jiang-zexuan/k230-42-stepper-vision-tracking-2d-gimbal/firmware/stm32f407/README.md

# STM32F407 固件

本目录预留给 STM32CubeIDE/CubeMX 工程、应用代码和板级代码。

当前状态：尚未创建 ioc 文件。板卡具体型号、时钟、串口实例、引脚复用和调试接口必须在查阅正点原子开发板资料并完成板级自检后写入工程。

规划分层：

- BSP：GPIO、UART、DMA、定时器和步进脉冲。
- Drivers：X42S STEP/DIR/EN、K230 协议、日志接口。
- Services：运动规划、位置估算、目标跟踪、故障管理。
- App：FreeRTOS 任务与系统状态机。
- Tests：可在主机或硬件环境复现的测试。
