jiang-zexuan/k230-42-stepper-vision-tracking-2d-gimbal/scripts/protocol-tools/README.md

# 协议工具

后续存放 UART 帧生成、CRC 校验和解析回放工具。工具输入输出格式及测试向量必须与 docs/03-interfaces/k230-f407-uart.md 一致。
