jiang-zexuan/k230-42-stepper-vision-tracking-2d-gimbal/hardware/datasheets/yahboom-k230-standard/README.md

# Yahboom K230 标准版资料索引

本目录包含用户提供的 15 张原始说明图，直接纳入 Git。图片是供应商资料副本，不替代最新官网文档或模块丝印核对。

## 已确认的可查找信息

| 原图 | 主题 | 可引用的关键事实 | 状态 |
| --- | --- | --- | --- |
| K230视觉模块-标准版_1.jpg | 封面 | 标准版资料集合的来源。 | 资料证据 |
| K230视觉模块-标准版_2.jpg | 包装与清单 | 可用于核验随附配件。 | 待逐项核对 |
| K230视觉模块-标准版_3.jpg | 接口概览 | 展示板载接口与 12 Pin 扩展口。 | 资料证据 |
| K230视觉模块-标准版_4.jpg | 12 Pin GPIO | 标注 IO33 为 UART3_RXD、IO32 为 UART3_TXD；存在 GND 与 5 V 引脚。 | 待实物核对 |
| K230视觉模块-标准版_5.jpg 至 _8.jpg | 散热支架装配 | 用于机械安装参考。 | 待采用时核对 |
| K230视觉模块-标准版_9.jpg | TF 卡安装 | 用于存储卡操作参考。 | 资料证据 |
| K230视觉模块-标准版_10.jpg 至 _14.jpg | CanMV IDE 与示例 | 用于现成视觉示例运行参考。 | 待复现实测 |
| K230视觉模块-标准版_15.jpg | 功能布局与常见问题 | 用于模块能力和使用注意事项索引。 | 待逐项核对 |

## 当前引用规则

- UART3 接线设计基线仅引用 _4.jpg 中的命名：IO32/TXD、IO33/RXD。连接前必须复核模块丝印和最新厂商资料。
- 资料中出现的典型电流、供电和能力描述都不是本项目的实测结果；项目电气参数以未来实验记录为准。
- 需要引用某一页时，写出完整文件名、资料版本（如可识别）和该页可见内容，避免只凭记忆转述。
