jiang-zexuan/k230-42-stepper-vision-tracking-2d-gimbal/docs/03-interfaces/pin-map.md

# PanView 接线与引脚基线

- 记录日期：2026-09-02
- 适用工程：`E:\Fluushbonading\FreeRTOS\Project\PanView`
- 参考工程：`firmware/stm32f407/PanViewF407`
- 当前状态：设计基线；新工程首次生成后需在 CubeMX、开发板丝印和实机上复核
- 接线变更：用户确认与旧工程相同，当前按原接线使用

## 证据和状态说明

本表的 F407 引脚来自旧工程 `PanViewF407.ioc`、`Core/Inc/main.h` 和 `Core/Src/main.c`；“接线未变”来自 2026-09-02 的操作者确认。它可以作为新工程 CubeMX 配置基线，但不替代新工程的引脚复核、万用表检查和低风险上电验证。

状态含义：

- **设计基线**：允许用于创建新工程配置，尚未代表新工程实测。
- **用户确认沿用**：接线相对旧工程未变的当前输入。
- **待验证**：需要通过 CubeMX 配置检查、开发板资料或实机测量确认。

## K230 与 F407 视觉串口

| 设备 | 信号 | 引脚/接口 | 连接方向 | 证据 | 状态 |
| --- | --- | --- | --- | --- | --- |
| K230 标准版 | UART3_TXD | IO32 | K230 TX -> F407 USART2_RX | 旧项目 pin-map 与用户沿用确认 | 用户确认沿用；待验证 |
| K230 标准版 | UART3_RXD | IO33 | F407 USART2_TX -> K230 RX | 旧项目 pin-map 与用户沿用确认 | 用户确认沿用；待验证 |
| K230 标准版 | 5V | 专用 UART 接口 5V | 供电 | 用户提供 | 用户确认沿用；待验证 |
| K230 标准版 | GND | 专用 UART 接口 GND | 与 F407、驱动器逻辑地共地 | AGENTS.md 接线约束与用户沿用确认 | 用户确认沿用；待验证 |
| STM32F407 | USART2_TX | PA2 | -> K230 RX | `PanViewF407.ioc` | 设计基线；待验证 |
| STM32F407 | USART2_RX | PA3 | <- K230 TX | `PanViewF407.ioc` | 设计基线；待验证 |
| STM32F407 | USART2_RX DMA | DMA1 Stream 5 | USART2 接收搬运 | `PanViewF407.ioc` | 设计基线；待验证 |

说明：F407 端的 K230 接收业务归属 USART2；新架构中 USART2 DMA/IDLE 的中断只负责搬运数据和通知 `VisionRxTask`。

## USART1 调试日志和文本命令

| 信号 | F407 引脚 | 用途 | DMA/中断 | 状态 |
| --- | --- | --- | --- | --- |
| USART1_TX | PA9 | 调试日志、遥测和命令响应 | USART1 IRQ | 设计基线；待验证 |
| USART1_RX | PA10 | PC/调试端命令接收 | DMA2 Stream 2 + USART1 IRQ | 设计基线；待验证 |
| USART1_RX DMA | DMA2 Stream 2 | 接收搬运 | DMA IRQ 优先级沿用旧工程 | 设计基线；待验证 |

USART1 的发送必须由统一发送服务保护；新架构中不允许多个任务直接并发调用阻塞式 HAL 发送。

## X42S 两轴 STEP/DIR/EN

| 轴 | 信号 | F407 引脚 | 定时器 | 旧工程语义 | 状态 |
| --- | --- | --- | --- | --- | --- |
| 水平轴 | STEP | PB6 | TIM4_CH1 PWM | 由 TIM4 产生脉冲 | 用户确认沿用；待验证 |
| 水平轴 | DIR | PB7 | GPIO 输出 | 方向电平由旧工程方向映射决定 | 用户确认沿用；待验证 |
| 水平轴 | EN | PG15 | GPIO 输出 | 旧工程 `SET` 为接管/使能，`RESET` 为失能；电气有效电平需实测 | 用户确认沿用；待验证 |
| 俯仰轴 | STEP | PC9 | TIM3_CH4 PWM | 由 TIM3 产生脉冲 | 用户确认沿用；待验证 |
| 俯仰轴 | DIR | PC8 | GPIO 输出 | 旧工程已实测方向映射：低电平向上、高电平向下 | 旧工程实测；新工程待复核 |
| 俯仰轴 | EN | PC7 | GPIO 输出 | 旧工程 `SET` 为接管/使能，`RESET` 为失能；电气有效电平需实测 | 用户确认沿用；待验证 |
| 逻辑地 | GND | 驱动器逻辑地 | 与 F407/K230 共地 | AGENTS.md 接线约束 | 用户确认沿用；待验证 |

定时器约束：TIM3/TIM4 继续负责精确 STEP 波形；`StepperTask` 只更新方向、使能、频率和运行状态，不使用 `osDelay()` 生成脉冲。

## TFT（ILI9341 类 SPI）

| 信号 | F407 引脚/接口 | 状态 |
| --- | --- | --- |
| SCK | PB3 / SPI1_SCK | 设计基线；待验证 |
| MISO | PB4 / SPI1_MISO | 设计基线；待验证 |
| MOSI | PB5 / SPI1_MOSI | 设计基线；待验证 |
| CS | PC13 / GPIO，标签 `TFT_LCD_CS` | 设计基线；待验证 |
| DC | PA5 / GPIO，标签 `TFT_LCD_DC` | 设计基线；待验证 |
| RST | PA6 / GPIO，标签 `TFT_LCD_RST` | 设计基线；待验证 |
| BL | PB15 / GPIO，标签 `TFT_LCD_BL` | 设计基线；待验证 |

旧 `.ioc` 中 SPI1 波特率配置为 8.0 Mbit/s；新工程应先沿用配置，再通过显示初始化和纯色刷新实测。

## FT6336G 触摸

| 信号 | F407 引脚/接口 | 状态 |
| --- | --- | --- |
| SCL | PB8 / I2C1_SCL | 设计基线；待验证 |
| SDA | PB9 / I2C1_SDA | 设计基线；待验证 |
| RST | PE5 / GPIO，标签 `CTP_RST` | 设计基线；待验证 |
| INT | PE6 / GPIO 输入，标签 `CTP_INT` | 设计基线；待验证 |

当前旧工程采用触摸轮询；是否在新工程启用 INT 唤醒，作为 InputTask 后续小任务的单独设计决策。

## ES8388 音频

| 信号 | F407 引脚/接口 | 状态 |
| --- | --- | --- |
| I2S_WS | PB12 / I2S2_WS | 设计基线；待验证 |
| I2S_CK | PB13 / I2S2_CK | 设计基线；待验证 |
| I2S_SD | PC3 / I2S2_SD | 设计基线；待验证 |
| I2S_MCK | PC6 / I2S2_MCK | 设计基线；待验证 |
| 配置总线 SCL | PB8 / I2C1_SCL | 与 FT6336G 共用 I2C1，地址和仲裁需复核 | 待验证 |
| 配置总线 SDA | PB9 / I2C1_SDA | 与 FT6336G 共用 I2C1，地址和仲裁需复核 | 待验证 |

旧 `.ioc` 目标音频频率为 48 kHz，实际值记录为 46.875 kHz；新工程先记录为配置基线，不当作新工程实测值。

## 按键、状态灯和命中指示

| 功能 | F407 引脚 | 旧工程输入/输出语义 | 状态 |
| --- | --- | --- | --- |
| KEY0 | PE4 | GPIO 输入，上拉，按下为低电平 | 用户确认沿用；待验证 |
| KEY1 | PE3 | GPIO 输入，上拉，按下为低电平 | 用户确认沿用；待验证 |
| KEY2 | PE2 | GPIO 输入，上拉，按下为低电平 | 用户确认沿用；待验证 |
| KEY_UP | PA0 | GPIO 输入，下拉，按下为高电平 | 用户确认沿用；待验证 |
| 状态 LED | PF9 | GPIO 输出，旧工程初始化为高电平 | 用户确认沿用；待验证 |
| 命中指示 | PF10 | GPIO 输出，旧工程高电平点亮、低电平关闭 | 用户确认沿用；待验证 |

## 调试和复核清单

新工程 T00 首次生成后必须逐项确认：

1. CubeMX 的引脚标签、外设复用和 DMA Stream 与本表一致。
2. PA13/PA14 SWD 调试接口未被占用。
3. 两个定时器 PWM 输出没有被其他外设复用覆盖。
4. I2C1 共用设备地址不冲突，必要时通过总线扫描或读 ID 验证。
5. UART 逻辑电平、5V 供电和共地在接线前依据开发板和模块资料复核。
6. 新工程下载后先验证 LED/UART，再验证 TFT/触摸，最后才接入电机使能和 STEP 输出。
