jiang-zexuan/k230-42-stepper-vision-tracking-2d-gimbal/docs/00-project/中文导航.md

# PanView 中文学习导航

本项目以中文学习说明为主，保留代码中的英文术语、HAL API 和变量名。这样既能看懂工程意图，也能与 STM32 官方资料和真实代码一一对应；不维护两套内容相同的中英文文档。

## 从哪里开始看

1. 先读[项目化学习规划书](project-based-learning-plan.md)，了解 P01 到 P12 的目标与验收条件。
2. 再读[学习地图](learning-map.md)，把每个小项目放回最终双轴跟踪云台的数据流中理解。
3. 进入当前固件工程：[PanViewF407](../../firmware/stm32f407/PanViewF407)。手写学习代码位于 `Core/Inc`、`Core/Src` 和 `Tests`；CubeMX/ST 自动生成代码保持原样。

## 已完成学习记录

| 阶段 | 核心能力 | 复盘 | 实测与测试 |
| --- | --- | --- | --- |
| P01 板级诊断台 | CubeIDE、SWD、LED、KEY0、USART1 串口日志 | [P01 复盘](../05-learning-log/p01-f407-board-diagnostics-review.md) | [实验 EXP-0002](../06-experiments/EXP-0002-f407-board-bringup.md)，[测试 TEST-0001](../07-test/TEST-0001-f407-board-bringup.md) |
| P02 非阻塞定时任务台 | SysTick、软件周期任务、按键消抖状态机 | [P02 复盘](../05-learning-log/p02-nonblocking-timed-tasks-review.md) | [实验 EXP-0003](../06-experiments/EXP-0003-p02-nonblocking-timed-tasks.md)，[测试 TEST-0002](../07-test/TEST-0002-p02-nonblocking-timed-tasks.md) |
| P03 UART DMA 协议实验器 | DMA、IDLE、流式组帧、CRC、超时、序号统计 | [P03 复盘](../05-learning-log/p03-uart-dma-protocol-review.md) | [实验 EXP-0004](../06-experiments/EXP-0004-p03-uart-dma-protocol.md)，[测试 TEST-0003](../07-test/TEST-0003-p03-uart-dma-protocol.md) |
| P04 K230 视觉结果发布器 | 人脸检测、检测框、坐标、FPS、UART 文本输出 | [P04 复盘](../05-learning-log/p04-k230-vision-result-publisher-review.md) | [实验 EXP-0005](../06-experiments/EXP-0005-p04-k230-vision-result-publisher.md)，[测试 TEST-0004](../07-test/TEST-0004-p04-k230-vision-result-publisher.md) |
| P05 单轴闭环电机验收台 | STEP/DIR/EN、方向、固定角度、加减速、理论位置 | [P05 复盘](../05-learning-log/p05-single-axis-closed-loop-motor-review.md) | [实验 EXP-0006](../06-experiments/EXP-0006-p05-single-axis-pulse-lab.md)，[测试 TEST-0005](../07-test/TEST-0005-p05-single-axis-pulse-lab.md) |
| P06 单轴运动控制器 | 人工回零、脉冲边界、越界拒绝、梯形加减速、X42S 闭环反馈 | [P06 复盘](../05-learning-log/p06-motion-limits-review.md) | [实验 EXP-0007](../06-experiments/EXP-0007-p06-horizontal-motion-limits.md)，[测试 TEST-0006](../07-test/TEST-0006-p06-horizontal-motion-limits.md) |
| P07 双轴云台基础控制器 | 双轴 STEP/DIR/EN、方向校正、俯仰 ±90° 限制、人工接管 | [P07 复盘](../05-learning-log/p07-dual-axis-controller-review.md) | [实验 EXP-0008](../06-experiments/EXP-0008-p07-dual-axis-controller.md)，[测试 TEST-0007](../07-test/TEST-0007-p07-dual-axis-controller.md) |
| P08 K230-F407 通信链路 | 文本链路、UART 接收统计、逻辑分析仪定位和方向校正 | [P08 复盘](../05-learning-log/p08-k230-f407-link-review.md) | [实验 EXP-0009](../06-experiments/EXP-0009-p08-k230-f407-link.md)，[测试 TEST-0008](../07-test/TEST-0008-p08-k230-f407-link.md) |
| P09 单轴视觉跟踪器 | 目标误差、死区、比例速度、丢失停机 | [P09 复盘](../05-learning-log/p09-horizontal-visual-tracking-review.md) | [实验 EXP-0010](../06-experiments/EXP-0010-p09-horizontal-visual-tracking.md)，[测试 TEST-0009](../07-test/TEST-0009-p09-horizontal-visual-tracking.md) |
| P10 双轴视觉跟踪器 | 双轴视觉状态机、TFT、触摸、音效和 LOCKED 提示 | [P10 复盘](../05-learning-log/p10-f407-tft-display-review.md) | [实验 EXP-0011](../06-experiments/EXP-0011-p10-visual-state-machine.md)，[测试 TEST-0012](../07-test/TEST-0012-p10-dual-axis-visual-state-machine.md) |
| P11 FreeRTOS 与故障管理 | 任务拆分、消息队列、遥测、SafetyTask、IWDG | [P11 复盘](../05-learning-log/p11-freertos-fault-management-review.md) | 串口日志：`D:\工具资源\XCOM（正点原子推荐）\p11调试日志.txt` |

## 当前与后续

- 当前：P11 FreeRTOS 与故障管理已完成正常运行验收，主线阶段性成果已合并到 `main`。
- 后续：进入 P12 附加内容，推进自定义模型、部署、故障注入、长时间运行和作品集交付。

## 关键术语

| 英文术语 | 中文理解 |
| --- | --- |
| GPIO | 通用输入输出引脚；本项目中用于读取 KEY0、控制 DS0。 |
| UART / USART | 串行通信外设；USART1 经 CH340C 与 PC 串口相连。 |
| HAL | ST 提供的硬件抽象层；例如 `HAL_GetTick()` 读取毫秒时间。 |
| SysTick | Cortex-M 的系统节拍定时器；HAL 默认用它产生毫秒时间基准。 |
| 非阻塞 | 不在等待期间停住 CPU；例如用时间差判断 20 ms 是否已过去。 |
| 状态机 | 用变量保存“现在处于哪一步”，让程序按事件与时间推进。 |
| DMA | 直接存储器访问；外设可把数据搬入内存，减少 CPU 逐字节参与。 |
| CRC | 循环冗余校验；通信中用于判断一帧数据是否被破坏。 |
