jiang-zexuan/k230-42-stepper-vision-tracking-2d-gimbal/docs/03-interfaces/fault-codes.md

# 故障码

| 编号 | 名称 | 触发条件 | 安全动作 | 状态 |
| --- | --- | --- | --- | --- |
| F001 | VISION_TIMEOUT | 超过 300 ms 未收到有效视觉帧 | 停止电机，进入 LOST | 设计 |
| F002 | UART_FRAME_ERROR | 长度、版本或帧结构非法 | 丢弃帧并累计错误 | 设计 |
| F003 | UART_CRC_ERROR | CRC16 校验失败 | 丢弃帧并累计错误 | 设计 |
| F004 | SOFTWARE_LIMIT | 目标运动将超出软件范围 | 拒绝外向运动，保留状态 | 设计 |
| F005 | TASK_HEARTBEAT | 关键任务心跳异常 | 停止电机，记录状态 | 设计 |
| F006 | WATCHDOG_RESET | 看门狗导致复位 | 启动后保留复位原因 | 设计 |

故障枚举、持久化方式和具体报码接口将在 FreeRTOS 阶段实现前固定。
