jiang-zexuan/k230-42-stepper-vision-tracking-2d-gimbal/hardware/mechanical/README.md

# 机械结构

存放双轴云台尺寸、装配图、转动范围、线束余量和负载测试记录。

水平轴设计范围为 -180 到 +180 度。该范围可能使线束发生扭转，装配后必须通过缓慢全行程实测确认线束余量和无干涉状态。
