jiang-zexuan/k230-42-stepper-vision-tracking-2d-gimbal/docs/05-learning-log/README.md

# 学习日志

每周在 weekly 目录中复制 week-template.md，记录本周知识、提交、实测证据、未解决问题和下周目标。日志只陈述已有证据支持的结论。
