jiang-zexuan/k230-42-stepper-vision-tracking-2d-gimbal/docs/05-learning-log/p11-freertos-fault-management-review.md

# P11：FreeRTOS 任务并发与卡死故障排查复盘

- 日期：2026-08-24
- 分支：`feature/f407-p11-freertos-fault-management`
- 最近基线提交：`6b48a6e feat(p10): add hit audio and stabilize visual tracking`
- 原始证据：`D:\工具资源\XCOM（正点原子推荐）\p11调试日志.txt`
- 最新原始证据 SHA-256：`845BC8D6C7F1003352B1CE920EBDC902C3FA89F8C4F43D829CCF2178377B7949`
- StatusTask 拆分后的最新原始证据 SHA-256：`6A77635DF27DAB49EE7909604CF49937EFC5BAEFA53CDB3381ED6DA56C70CFDE`
- 上一轮故障定位日志 SHA-256：`BD537E4901B98E24DD5E769289F04E5432927F026465DD9E7905C0CCB00736D`
- 本轮状态：InputTask 和视觉超时 SafetyTask 已完成现场验收；控制任务失活和软件越界注入仍待验证。

## 这次遇到的故障

在屏幕上连续按几次“启动/停止”后，曾出现以下现象：

- 电机像是失去正常控制，可能持续转动或不再更新；
- TFT 状态界面停止刷新；
- USART1 串口不再输出，包括 `RTOS heartbeat`；
- 只能手动复位 F407 才恢复。

这不是“电机一定坏了”的结论，而是一个需要分层定位的系统故障：视觉接收、控制任务、TFT 刷新、串口日志和电机 STEP 都可能是原因。

## 稳定复现与取证

已按以下顺序复现和记录：

1. 上电运行 P11 固件，确认有 `PanView P11 boot`、心跳和 K230 接收日志。
2. 在 TFT 主页反复按启动/停止区域，观察电机、屏幕和 USART1 是否同时停止。
3. 发生卡死时保留串口日志，最后再手动复位，避免把复位后的启动日志和故障现场混在一起。
4. 在代码中加入临时 `UI refresh begin` / `UI refresh end` 标记，再重复测试，用于判断是否卡在 TFT 刷新函数内部。

这里的关键取证原则是：先记录“最后一条完整日志”和“哪个周期性信号消失”，再讨论根因；不能只根据电机现象猜测。

## 初始假设与排除过程

| 假设 | 验证方法 | 结果 |
| --- | --- | --- |
| K230 停止发送，导致控制逻辑失去更新 | 查看 K230 接收帧数、文本解析数和最后有效帧 | 最新会话中 `RX frames` 持续增加到约 `1924`，不是本轮根因 |
| TFT SPI 刷新函数内部死循环 | 在刷新调用前后分别打印 `UI refresh begin/end` | 最新会话中每个 `begin` 都有对应的 `end`，未证明卡在刷新函数内部 |
| 软件限位触发后电机仍被错误驱动 | 查看 `VIS state=FAULT`、`pan_run/pitch_run` 和位置 | 日志显示限位故障时两轴运行标志为 `0`；限位保护本身在工作 |
| FreeRTOS 心跳任务失活 | 查看 `RTOS heartbeat` 是否连续 | 修复后的会话从 `0` 连续到 `96`，任务没有失活 |
| USART1 多个执行上下文同时调用阻塞式 HAL 发送 | 检查所有 `HAL_UART_Transmit(&huart1, ...)` 调用，并寻找截断日志 | 发现 `PanViewTask` 与心跳任务都能输出 USART1；历史日志出现过被截断的 `RTOS hea`，高度指向并发访问风险 |

## 根因判断

当前最有证据支持的判断是：USART1 被多个 FreeRTOS 任务/执行路径直接调用 `HAL_UART_Transmit()`，而 HAL UART 发送状态和数据寄存器操作不是可重入接口。两个上下文同时进入阻塞发送时，可能发生以下情况：

1. 一个发送尚未结束，另一个上下文修改同一个 `UART_HandleTypeDef` 的状态；
2. 两条日志的字节交错或只发送了一部分，出现 `RTOS hea` 这样的截断行；
3. 某个调用长时间等待 HAL 状态恢复，表现为日志、界面和控制任务像“全部卡住”。

这是“最可能根因”，不是仅凭一条截断日志就能数学证明的结论。要完全证明，还需要在故障注入条件下采集任务状态、栈余量和 UART HAL 状态。

## 修复方式

已在 FreeRTOS 初始化阶段创建 `Usart1TxMutex`，并在 `PanView_Uart1Transmit()` 中统一保护 USART1 的阻塞发送：

1. 发送前获取 USART1 TX 互斥锁；
2. 调用一次完整的 `HAL_UART_Transmit()`；
3. 发送完成后释放互斥锁；
4. 内核尚未运行时，或发送的不是 USART1 时，直接走原有 HAL 调用，保证启动阶段和 USART3 电机 TTL 通道不被错误套锁。

同时保留了 `UI refresh begin/end` 临时日志，帮助确认界面刷新边界。这个标记属于诊断手段，后续正式版本可以降低频率或移除，避免日志本身成为新的时序干扰。

## 修复后实测证据

最新日志末尾包含：

```text
RTOS heartbeat=89 vision_rx=1792 vision_drop=0
...
RTOS heartbeat=90 vision_rx=1816 vision_drop=0
...
RTOS heartbeat=91 vision_rx=1833 vision_drop=0
...
RTOS heartbeat=92 vision_rx=1851 vision_drop=0
...
RTOS heartbeat=93 vision_rx=1872 vision_drop=0
...
RTOS heartbeat=94 vision_rx=1889 vision_drop=0
...
RTOS heartbeat=95 vision_rx=1905 vision_drop=0
...
RTOS heartbeat=96 vision_rx=1924 vision_drop=0
```

已观察到：

- FreeRTOS 心跳持续递增，没有在多次触摸后停止；
- K230 接收帧持续增长；
- `UI refresh begin` 和 `UI refresh end` 成对出现；
- 发生软件限位时，日志出现 `VIS state=FAULT reason=software_limit`，并且 `pan_run=0 pitch_run=0`；
- 最新会话未再次出现原先的“串口、屏幕、任务同时停止”现象。

注意：`K230 state ... drop=916` 与 `RTOS heartbeat ... vision_drop=0` 不是同一个计数器。前者是视觉接收/解析链路的统计，后者是 FreeRTOS 视觉消息队列统计；两者必须分别解释，不能直接相加或互相替代。

## P11 第二步：任务健康遥测

在完成串口互斥保护后，已继续补充任务级遥测，但这部分还没有新的烧录日志，暂不写成“实测通过”。每秒心跳现在计划输出：

```text
RTOS heartbeat=... pan_steps=... vision_rx=... vision_drop=... \
stack_words={pan:... vision:... heartbeat:...} \
state={pan:... vision:... heartbeat:...}
```

字段含义：

- `pan_steps`：上一秒 `PanViewTask` 执行 `PanView_AppStep()` 的次数。接近预期周期，说明任务持续获得运行机会；突然变成 0 或明显下降，说明任务被阻塞、被抢占过久或调度异常。
- `vision_rx` / `vision_drop`：FreeRTOS 视觉消息队列成功接收和丢弃计数，不等同于 K230 UART 解析器的 `drop`。
- `stack_words`：`uxTaskGetStackHighWaterMark()` 返回的历史最低剩余栈空间，单位是 FreeRTOS 栈字，不是字节。数值越小，越接近栈溢出风险。
- `state`：CMSIS-RTOS 任务状态数值，用来辅助判断任务是运行、就绪、阻塞还是被挂起；具体数值解释以当前 CMSIS-RTOS 头文件定义为准。

代码动作 -> 工程意图：

| 代码动作 | 工程意图 | 大白话描述给 AI |
| --- | --- | --- |
| `pan_view_step_count++` | 记录控制任务实际执行次数 | “每秒告诉我控制任务到底跑了多少次。” |
| `uxTaskGetStackHighWaterMark()` | 观察任务历史最低栈余量 | “不要等栈溢出死机，提前告诉我还剩多少栈。” |
| `osThreadGetState()` | 输出任务调度状态 | “把任务当前是运行、等待还是挂起也打印出来。” |
| 扩大心跳缓冲区并一次性组装 | 保证遥测行不会因字段增加而截断 | “日志字段变多后，先放进足够大的缓冲区再完整发送。” |

### 第二步实测结果

本次新日志从 `RTOS heartbeat=0` 连续记录到 `RTOS heartbeat=23`，共 24 个心跳周期，期间没有再次出现串口、屏幕和任务同时停止。

| 项目 | 实测结果 | 判断 |
| --- | --- | --- |
| 心跳 | `0` 连续到 `23` | `P11HeartbeatTask` 持续运行 |
| `pan_steps` | 首秒为 `1`；之后 `480~700`，平均约 `595` 次/秒 | 任务持续运行，但没有达到理想的 1 ms 一次 |
| FreeRTOS `vision_rx` | `3` 增长到 `474` | 视觉消息持续进入队列处理任务 |
| FreeRTOS `vision_drop` | 全程 `0` | 队列没有丢弃消息 |
| `stack_words.pan` | 启动后最低约 `1745` | 暂未接近栈耗尽 |
| `stack_words.vision` | 稳定约 `463` | 暂未接近栈耗尽 |
| `stack_words.heartbeat` | 稳定约 `389` | 暂未接近栈耗尽 |
| 任务状态 | `pan=3`、`vision=3`、`heartbeat=2` | 按 CMSIS-RTOS2 定义，前两者处于阻塞/等待，心跳任务在采样时运行 |

`pan_steps` 没有达到 1000，并不表示任务死了。当前 `PanViewTask` 每轮除了控制判断，还会执行触摸读取、TFT 局部刷新、状态日志和其他周期任务；这些同步操作占用 CPU 后，`osDelay(1)` 只能保证“至少延时一个 tick”，不能保证每轮总耗时恰好 1 ms。

这暴露出 P11 的下一项工程问题：**控制任务的周期不应被显示和日志拖慢**。当前 STEP 波形由硬件定时器维持，因此不会直接因为 `pan_steps` 低于 1000 而改变脉冲频率；但视觉误差更新、限位检查和状态响应会出现周期抖动，目标快速移动时可能降低跟手性。

## 代码动作 -> 工程意图

| 代码动作 | 工程意图 | 大白话描述给 AI |
| --- | --- | --- |
| `osMutexNew(&usart1TxMutex_attributes)` | 建立 USART1 发送资源的唯一访问权 | “多个任务都要打印日志，请先给串口发送加一把锁。” |
| `PanView_Uart1Transmit()` | 统一封装 USART1 发送并处理内核未启动场景 | “以后所有 USART1 日志都走同一个安全入口。” |
| `osMutexAcquire()` / `osMutexRelease()` | 保证一条日志完整发送，不与另一条日志交错 | “一条日志没发完之前，其他任务先等一下。” |
| `StartTask02()` | 每秒输出心跳和队列统计 | “用周期性生命信号证明任务还活着，并带上关键遥测。” |
| `UI refresh begin/end` | 标记可疑的显示刷新区间 | “在函数前后打路标，判断程序到底卡在哪里。” |
| `osMessageQueuePut/Get()` | 将视觉结果从接收路径交给 RTOS 任务 | “接收和处理解耦，任务之间用队列传递一帧结构化数据。” |

## 这次真正学到的调试方法

1. **先判断故障范围**：心跳、K230 接收、屏幕刷新和电机运行是四条独立证据链。哪条还在工作，哪条已经停止，决定下一步查哪里。
2. **用日志证明任务是否活着**：周期性心跳比“我感觉卡了”可靠；同时记录接收计数，避免把通信问题误认为 RTOS 问题。
3. **给可疑函数加前后标记**：只有 `begin` 没有 `end`，才说明可能卡在该函数或其调用链；两者成对出现，就应把注意力移开。
4. **检查共享外设的所有调用者**：看到一个 `HAL_UART_Transmit()` 不够，必须搜索整个工程，确认同一个 UART 是否被多个任务、回调或中断使用。
5. **区分“修复后通过”和“根因已证明”**：互斥锁后长时间稳定是强证据，但还不能替代任务栈、优先级、阻塞时长和故障注入测试。
6. **不要用日志任务承担安全动作**：日志可以延迟或丢失，STEP 停止、EN 释放和软件限位必须由独立的高可靠控制路径完成。

## P11 第三步：先迁移遥测任务

已将原来 `PanView_AppStep()` 中的两类日志工作迁移到独立的 `TelemetryTask`：

- 每秒输出一次 K230 汇总日志；
- 每 5 秒输出一次裸机周期心跳、扫描计数和链路状态。

本次只迁移遥测，触摸、视觉状态机、电机控制和安全停止仍由 `PanViewTask` 执行，目的是保持已经验证的控制行为不变。`TelemetryTask` 当前为低优先级，且所有 USART1 输出仍经过同一个互斥锁。

代码动作 -> 工程意图：

| 代码动作 | 工程意图 | 大白话描述给 AI |
| --- | --- | --- |
| `TelemetryTask` | 让周期日志脱离控制任务 | “日志慢一点没关系，不要占用电机控制任务的时间。” |
| `PanView_TelemetryStep()` | 集中管理 K230 汇总和心跳周期 | “把所有低实时性的统计输出放进遥测模块。” |
| 从 `PanView_AppStep()` 删除日志分支 | 缩短控制任务单次执行路径 | “控制任务只处理控制相关事情，别在里面打印大段文本。” |

### 第三步待实测

本次代码已经完成静态检查，但还没有新的烧录日志，因此不能提前写成通过。下一次实测重点是：

1. `pan_steps` 平均值是否明显高于上一轮约 `595` 次/秒；
2. `K230 state` 和 `t=... heartbeat` 是否仍按原周期输出；
3. 连续触摸启动/停止后，`RTOS heartbeat` 是否继续递增；
4. `vision_drop` 是否保持为 0；
5. 电机运动、软件限位和屏幕刷新行为是否与迁移前一致。

### 第三步首次复测发现的新问题

本次日志中 `RTOS heartbeat` 可以持续到 `19`，但没有出现迁移后应由 `TelemetryTask` 输出的 `K230 state=...` 或 `t=... heartbeat=...`。因此只能确认原有 `P11HeartbeatTask` 仍在运行，不能确认新遥测任务已经成功创建。

结合 `configTOTAL_HEAP_SIZE=15360` 和当前多个任务的栈配置，初步怀疑新增任务创建时接近或超过 FreeRTOS heap 上限。这个判断还需要通过任务句柄状态实测确认，不能仅凭日志缺少某类文本就直接定论。

已做两项诊断调整：

- 将 `TelemetryTask` 栈从 `512 * 4` 字节降为 `256 * 4` 字节；
- 在原有 RTOS 心跳中增加 `telemetry` 任务状态，句柄为空时输出 `0`。

下一次日志若 `telemetry` 状态为非 0 且出现 `K230 state`，才算完成“遥测任务成功创建并运行”的验收。

## 第三步复测结果

重新调整任务栈和 heap 后，日志已经证明：

- `state={... telemetry:3 ...}`，遥测任务已成功创建并持续运行；
- `K230 state=...` 每秒输出；
- `t=... heartbeat=...` 每 5 秒输出；
- `RTOS heartbeat` 连续到 `20`，`vision_drop=0`；
- 新增任务没有造成栈余量快速下降。

### StatusTask 复测结果

本次新日志已经取得有效证据：

- `status=3`，StatusTask 已成功运行；
- `UI refresh begin` 与 `UI refresh end` 仍成对出现；
- `RTOS heartbeat` 连续到 `34`，`vision_drop=0`；
- `pan_steps` 在没有频繁触摸时稳定在约 `1024~1048` 次/秒，相比迁移前约 `556` 次/秒明显改善；
- 触摸启动/停止后，`pan_steps` 会短暂降到约 `947~994`，随后恢复，没有出现任务卡死。

同时发现旧版 `256 * 4` 字节配置下 `stack_words.status=23`，即 StatusTask 历史最低只剩约 23 个 FreeRTOS 栈字，虽然尚未溢出，但余量过小。已将 StatusTask 栈扩大到 `512 * 4` 字节；本次日志对应的是扩大前版本，扩大后的余量待下一次烧录确认。

## 尚未完全证明的风险

- `HAL_UART_Transmit()` 仍是阻塞式发送；如果日志量突然增大，持锁时间会变长，可能影响实时任务。后续可改为单独日志队列 + 单发送任务，或使用 DMA/中断发送。
- 目前只保护了 USART1 的任务级发送；任何 ISR 中都不能调用会获取 mutex 的接口。中断只能置位事件或写入无锁缓冲区。
- `SafetyTask` 已加入代码，但尚未完成“断开视觉通信”和“控制任务失活”的现场故障注入，因此不能把代码存在等同于硬件级保护已验证。
- 任务栈余量、`pan_steps` 和任务状态已经加入代码；最新 InputTask 日志中 `status=3` 且 `stack_words.status=279`，StatusTask 扩栈后的余量已有现场证据。
- 任务健康遥测、TFT 刷新和触摸采集已经从控制任务中迁出；真正改变电机状态的 UI 事件仍由 `PanViewTask` 串行执行。

## P11 第四步：InputTask 与触摸事件队列实测

已将触摸采集从控制任务中拆出：`InputTask` 周期读取 FT6336G，完成原始坐标到屏幕坐标的转换，再把触摸消息放入 `UiTouchQueue`。`PanViewTask` 只负责取出事件并执行启动、停止、人工回中、页面切换和安全动作；输入任务不直接控制电机。

最新日志文件为 `D:\工具资源\XCOM（正点原子推荐）\p11调试日志.txt`，SHA-256 为 `BA00B6A986A836841BA480348075D44BF026EB067D330BF7E40FC58B6FACD8BB`。本次最新运行从后半段开始统计，不能与文件前面的旧运行拼接计算。

| 项目 | 最新实测 | 判断 |
| --- | --- | --- |
| `RTOS heartbeat` | 约 `20` 连续到 `43` | 调度系统持续运行 |
| `input` 任务状态 | `input=3`，栈余量约 `193` words | InputTask 已创建且有明显栈余量 |
| `status` 任务 | `status=3`，栈余量约 `279` words | TFT 刷新任务持续运行 |
| `telemetry` 任务 | `telemetry=3`，栈余量约 `165` words | 遥测任务持续运行 |
| 视觉消息队列 | `vision_drop=0` | RTOS 视觉队列未丢消息 |
| 控制周期 | `pan_steps` 大多约 `970~1027`/秒 | 控制任务保持接近 1 kHz 的运行机会 |
| 触摸事件 | `TOUCH point count=1 ... zone=bottom_left`，随后 `VIS state=SEARCH reason=waiting_for_takeover` | 触摸采集、投递和控制侧接管链路打通 |
| UI 刷新 | `UI refresh begin/end` 成对出现 | 未发现刷新函数卡死证据 |
| K230 接收 | `RX frames` 持续增长 | 视觉接收没有因 InputTask 拆分停止 |

### 这一步做了什么

- 将“读触摸”变成独立任务，避免 FT6336G 轮询和坐标处理拖慢控制任务。
- 用消息队列传递结构化触摸事件，生产者和消费者解耦。
- 保留控制动作的唯一入口在 `PanViewTask`，避免多个任务同时改变电机使能、位置有效标志和视觉接管状态。

### 代码动作 -> 工程意图

| 代码动作 | 工程意图 | 大白话描述给 AI |
| --- | --- | --- |
| `InputTask` 周期调用 `PanView_InputStep()` | 独立采集触摸硬件 | “专门安排一个任务看触摸屏，不要让主控制循环亲自等触摸。” |
| `PanView_RtosPublishTouch()` | 将坐标封装成消息投递到队列 | “读到一次触摸就发一张事件单，后面的人按单处理。” |
| `PanView_RtosProcessUiEvents()` | 在控制任务上下文消费事件 | “所有会改变电机和状态机的动作只在一个任务里执行。” |
| `UiTouchQueue` | 缓冲短时触摸事件 | “采集和处理速度不一致时，先排队，避免互相阻塞。” |

### 为什么事件队列不直接控制电机

触摸任务的职责是采集输入，不应直接调用电机控制。启动/停止还涉及人工回中、位置有效性、视觉接管和软件限位，必须由同一个控制任务串行完成。这样可以避免“触摸任务正在释放 EN、视觉任务同时又在发 STEP”的竞态条件；队列只传递意图，控制任务才执行动作。

### 当前结论

InputTask 拆分已通过本轮现场验收：任务创建成功、触摸事件仍能触发 `waiting_for_takeover`，视觉接收和控制周期未明显恶化，队列无丢帧，栈余量没有逼近耗尽。随后已加入 `SafetyTask` 代码，下一步只做编译、烧录和故障注入验收，不能提前宣称系统已具备任务失活时的硬件级保护。

## P11 第五步：SafetyTask 设计（待现场验收）

已加入独立的 `SafetyTask`，优先级高于普通控制和日志任务，周期为 10 ms。它不打印日志、不等待消息队列、不获取 USART1 互斥锁，只检查三类条件：

- `PanViewTask` 超过 200 ms 没有更新控制心跳：`control_task_stale`；
- K230 有效结果超过 300 ms 没有到达：`vision_timeout`；
- 下一步位置将越过水平或俯仰 ±90° 软件限位：`software_limit`（早期记录中的俯仰 ±45° 已由 P12 更新）。

触发后直接停止两路 STEP、释放两路 EN、清除位置有效标志、复位跟踪控制器，并锁存 `FAULT` 状态。再次启动前必须重新人工回中；故障原因由 `TelemetryTask` 在 `K230 state=... safety=...` 中输出。`configTOTAL_HEAP_SIZE` 已从 20480 增加到 24576 字节，为新增任务保留创建空间。

代码动作 -> 工程意图：

| 代码动作 | 工程意图 | 大白话描述给 AI |
| --- | --- | --- |
| `SafetyTask` 使用高优先级、10 ms 周期 | 让安全检查不依赖低优先级日志 | “日志任务卡住时，仍要有一个更优先的任务负责刹车。” |
| `last_pan_view_step_tick` | 监测控制任务是否还在运行 | “控制任务很久没报到，就认为它可能卡住。” |
| `PanView_SafetyStop()` | 统一执行停止、失能和位置失效 | “任何安全故障都走同一个急停动作，避免漏关某一路电机。” |
| `safety_fault_latched` | 保留故障原因并阻止自动重新运动 | “出过故障后先停住，必须重新回中才能再次接管。” |

### 下一次验收方式

先确认 `RTOS heartbeat` 中出现 `safety=3`、栈余量为正，再在关闭 K230 发送或拔掉视觉通信线的条件下观察：约 300 ms 内两轴 STEP 停止、EN 释放，随后日志出现 `safety=vision_timeout`。不要在电机高速运行时做第一次故障注入，先低速或断开 12 V 电源观察日志和 EN 电平。控制任务失活和软件越界的故障注入仍待后续安排。

### SafetyTask 视觉超时现场结果

本次最新运行的日志文件仍为 `D:\工具资源\XCOM（正点原子推荐）\p11调试日志.txt`，SHA-256 为 `845BC8D6C7F1003352B1CE920EBDC902C3FA89F8C4F43D829CCF2178377B7949`。最新会话从 `RTOS heartbeat=79` 附近开始，前面的内容属于旧运行，不能混合统计。

| 项目 | 实测证据 | 判断 |
| --- | --- | --- |
| SafetyTask 创建 | `state={... safety:3 ...}` | 任务已创建并持续处于调度状态 |
| SafetyTask 栈余量 | `stack_words ... safety:195` | 未接近栈耗尽 |
| 故障前系统 | `RTOS heartbeat=79` 连续到 `108`，`safety=clear` | 正常跟踪阶段运行稳定 |
| 视觉链路中断 | `RX frames=3192` 后不再增长，`text_ok=3176` 保持不变 | K230 有效帧停止到达 |
| 超时判定 | `VIS state=LOST reason=vision_timeout` | 原有视觉状态机先识别通信超时 |
| SafetyTask 接管 | `K230 state=FAULT safety=vision_timeout` | 独立安全任务锁存故障并进入 FAULT |
| 控制继续运行 | 故障后 `RTOS heartbeat=109` 连续到 `116` | 安全停机没有把系统整体卡死 |
| 软件运动状态 | 故障日志中 `pan_run=0 pitch_run=0` | 软件层两轴运行标志均已停止 |

这次已经证明“视觉数据停止 -> 超时故障 -> 软件停机 -> 心跳仍存活”的完整链路。串口日志没有直接测量 EN 电平和 STEP 波形，因此“引脚物理电平已经释放、定时器没有残余脉冲”仍应使用万用表或逻辑分析仪做一次独立确认；这不是当前日志能够单独证明的内容。

## P11 第六步：IWDG 硬件看门狗接入（待现场验收）

CubeMX 已生成 `iwdg.c` / `iwdg.h`，当前参数为 `Prescaler=64`、`Reload=4095`。主函数调用 `MX_IWDG_Init()` 启动独立看门狗，`SafetyTask` 每 10 ms 调用 `HAL_IWDG_Refresh(&hiwdg)`。按典型 32 kHz LSI 粗略估算，超时时间约为 8 秒；LSI 有误差，不能把这个数当成精确测量值。

这一步的关键不是“在任意地方不断喂狗”，而是把喂狗动作放在 SafetyTask：

- SafetyTask 正常运行，就能周期刷新 IWDG；
- SafetyTask 自身卡死或调度器失效，就没人刷新，IWDG 最终复位 MCU；
- 视觉超时由 SafetyTask 先执行停机并锁存故障，故障状态不会因为 IWDG 立即复位而掩盖现场。

代码动作 -> 工程意图：

| 代码动作 | 工程意图 | 大白话描述给 AI |
| --- | --- | --- |
| `MX_IWDG_Init()` | 启动 STM32 内部独立看门狗 | “让芯片内部有一个不依赖普通任务的倒计时器。” |
| `HAL_IWDG_Refresh(&hiwdg)` 放在 `SafetyTask` | 让安全任务成为唯一喂狗者 | “只有负责安全检查的任务还活着，系统才允许继续运行。” |
| 不在 `PanViewTask` 或 `TelemetryTask` 中喂狗 | 避免普通任务存活掩盖安全任务失活 | “日志还在打印，不代表安全控制还正常。” |

当前状态：代码已接入，尚未完成编译后的运行日志和“停止 SafetyTask 后约 8 秒复位”的故障注入测试。这个复位测试需要单独安排，不能用普通单步暂停替代，因为暂停 CPU 会同时暂停 IWDG 相关观察。

## P11 构建故障复盘：CubeMX 重生成后的函数丢失

启用 IWDG 后第一次 Keil 构建出现 22 个错误，主要包括：

- `freertos.c` 中心跳函数的局部变量缺失；
- `PanViewSafetyFault` 和安全故障枚举缺失；
- `hiwdg`、`huart1` 和 `snprintf` 的声明缺失；
- 链接阶段找不到 `PanView_AppStep`、`PanView_InputStep`、`PanView_TelemetryStep`、`PanView_UiRefreshStep`。

继续检查后确认，最后四个符号不是单纯的头文件问题，而是 `main.c` 中对应函数体已经被 CubeMX 重生成覆盖。判断依据是：文件中仍保留 `VisualState_Update()`、电机硬件函数和运行时变量，但四个函数名完全不存在；Keil 因此把大量变量和静态函数报成“未引用”。

排查和修复顺序：

1. 先看第一条错误，不被后续几十条连带警告带偏。
2. 用全文搜索确认声明、定义和调用是否成对存在。
3. 从已提交的 P10 完整源码恢复原主循环业务，再拆回四个 RTOS 入口。
4. 恢复触摸事件队列、视觉消息队列、局部 UI 刷新和 TelemetryTask 调用。
5. 恢复 `PanView_Uart1Transmit()` 的实现，确保 USART1 互斥锁仍有效。
6. 重新构建确认链接符号完整。

最终 Keil 构建结果：`PanViewF407.axf - 0 Error(s), 0 Warning(s)`，代码大小为 `67376`，并成功生成 `PanViewF407.hex`。这只证明源代码和链接恢复正确；IWDG 正常运行、视觉超时和硬件复位仍需重新烧录后现场验证。

代码动作 -> 工程意图：

| 代码动作 | 工程意图 | 大白话描述给 AI |
| --- | --- | --- |
| 全文搜索未定义符号 | 区分声明缺失、定义缺失和链接配置问题 | “先确认这个函数到底有没有实现，不要一看到错误就乱改头文件。” |
| 从已提交版本恢复业务逻辑 | 保留已验证功能，避免凭记忆重写 | “先找最后一个确定能工作的版本，再把新功能逐项接回。” |
| 恢复后重新构建 | 验证编译器和链接器都能看到完整调用链 | “编译通过不等于链接通过，必须看到最终 AXF 成功。” |

## 复习问题

## P11 第六步现场验收：任务堆不足与看门狗复位循环

本次原始证据仍为 `D:\工具资源\XCOM（正点原子推荐）\p11调试日志.txt`，本轮日志 SHA-256：
`B9A15A5AA8761D085719BF0197E30A88589D685FC812C796980C4EC4A237023B`。

### 现象与定位

修复前每次上电都能看到 `RTOS heartbeat=0、1、2`，随后再次出现 `AUDIO ES8388 init=ok` 和 `PanView P10 boot`。同时心跳中的 `status=0 input=0 safety=0`，说明这三个任务句柄为空，并不是 TFT 自己反复初始化。

根因链条如下：

1. FreeRTOS heap 只有 15 KiB，多个任务栈、TCB、互斥锁和消息队列同时创建时内存不足。
2. `StatusTask`、`InputTask`、`SafetyTask` 创建失败，句柄保持空值。
3. IWDG 在 `MX_FREERTOS_Init()` 之前已经启动，但 `SafetyTask` 不存在，没人刷新看门狗。
4. IWDG 超时后复位 MCU，于是表现为“上电后屏幕一直重启”。

### 修复动作

- 将 `configTOTAL_HEAP_SIZE` 从 `15360` 增加到 `32768` 字节。
- 将看门狗启动从 `main()` 移到 `SafetyTask` 首次运行之后；只有安全任务已经获得运行机会，才允许启动并继续刷新 IWDG。
- 在 `MX_FREERTOS_Init()` 结束处增加一次任务创建汇总日志，直接显示各任务、队列句柄和剩余 heap。

代码动作 -> 工程意图：

| 代码动作 | 工程意图 | 大白话描述给 AI |
| --- | --- | --- |
| `configTOTAL_HEAP_SIZE=32768` | 为当前任务栈和 RTOS 对象留出足够动态内存 | “这些任务加起来需要更多运行空间，不要让后创建的任务悄悄失败。” |
| `RTOS create ...` | 在调度器启动前确认每个对象是否创建成功 | “启动前把每个任务的成败直接打印出来。” |
| `SafetyTask` 首次调用 `MX_IWDG_Init()` | 防止安全任务不存在时进入必然复位循环 | “先确认负责喂狗的人已经上班，再启动倒计时。” |
| 后续只由 `SafetyTask` 调用 `HAL_IWDG_Refresh()` | 保持唯一喂狗者和安全职责一致 | “普通任务还活着，不代表安全任务还活着。” |

### 现场实测结果

最新日志首先出现：

```text
RTOS create pan=1 vision=1 telemetry=1 status=1 input=1 safety=1 queue=1 touch_queue=1 heap=13600
```

这证明六个业务任务和两个消息队列均创建成功。随后：

- `RTOS heartbeat` 从 `0` 连续增长到 `20`，没有重新出现启动日志；
- `state` 中 `status/input/safety` 均为非零，任务持续获得调度；
- `stack_words.status=279`、`input=193`、`safety=229`，没有接近栈耗尽；
- K230 `RX frames` 持续增长，视觉状态在 `TRACKING/LOCKED` 间正常变化；
- TFT 刷新 `UI refresh begin/end` 成对出现；
- 触摸、回中、双轴跟踪和命中音效均继续工作。

因此，本次可以确认：**屏幕反复重启的直接原因已排除，P11 的“任务创建成功 + 看门狗不再造成启动复位循环”已通过现场验收。**

本次只验证了正常运行下看门狗由 `SafetyTask` 喂养；尚未人为阻塞 `SafetyTask` 来验证 IWDG 是否按预期复位，这项故障注入可以作为后续独立实验，不影响本次正常启动结论。

### 为什么一次串口发送也需要互斥锁？

因为 `HAL_UART_Transmit()` 会读写同一个 UART 外设和 HAL 状态对象。即使每条日志本身是完整字符串，只要两个任务同时进入，访问顺序就不再受控；互斥锁把它变成“同一时刻只有一个发送者”。

### 为什么心跳正常不能证明整个系统绝对正常？

心跳只能证明心跳任务获得了运行机会并成功输出。它不能单独证明电机定时器、视觉控制状态机、TFT 刷新和 UART 接收都正常，所以必须结合多条证据链。

### 为什么要保留故障现场再复位？

复位会清空任务状态、UART HAL 状态和大部分运行变量。先保存故障前最后日志，才能知道系统在什么动作之后停止；复位后的 `boot` 只能证明系统重新启动，不能解释之前为什么死机。

## P12 入口问题复盘：上电后 TFT 反复刷新是否为看门狗复位

- 日期：2026-08-25
- 现象：上电后观察到 TFT 反复执行启动/刷新表现，怀疑程序卡死或没有喂狗。
- 当前证据状态：本次尚未提供新的串口日志或 RCC 复位标志，因此本节只记录排查方法和待验证判断；不能把本次现象直接写成已确认根因。

### 先把两个现象分开

“屏幕内容反复刷新”可能来自两种完全不同的原因：

1. **应用仍在运行但重复重绘**：串口心跳持续递增，启动日志只出现一次，TFT 刷新函数前后的标记成对出现。
2. **MCU 反复复位**：每次复位都会重新执行屏幕初始化，因此屏幕看起来像一直刷新；串口会反复出现 `AUDIO ...`、`PanView Pxx boot`，心跳从 `0` 重新开始。

第一步不是修改 TFT，而是保存上电后的完整串口输出，确认启动日志是否重复。

### 当前代码检查结果

已检查当前工作区：

- `main.c` 的外设初始化阶段没有调用 `MX_IWDG_Init()`；
- `SafetyTask` 首次获得运行机会后才调用 `MX_IWDG_Init()`，后续由它执行 `HAL_IWDG_Refresh()`；
- `FreeRTOSConfig.h` 曾被回退到 `configTOTAL_HEAP_SIZE=15360`，与已经通过现场验收的 32768 字节版本不一致；本次已恢复为 32768；
- 因此若 `StatusTask`、`InputTask` 或 `SafetyTask` 创建失败，必须先从 `RTOS create ...` 日志确认，不能仅凭屏幕现象断定是看门狗。

### 本次问题的复盘模板

| 环节 | 应记录的内容 |
| --- | --- |
| 现象 | 上电后 TFT 是否重复初始化，是否能看到完整启动画面 |
| 第一证据 | 启动日志是否重复、`RTOS heartbeat` 是否从 0 重新开始 |
| 任务证据 | `RTOS create` 中各任务句柄、队列句柄和剩余 heap |
| 复位证据 | `RCC->CSR` 中 IWDG 复位标志，读取后清除并记录 |
| 根因判断 | 任务创建失败、看门狗早期开启、TFT 重绘或其他阻塞原因 |
| 修复 | 只做一个最小修改，并说明为什么能切断根因链 |
| 验证 | 重新编译、烧录、观察心跳和启动次数，再做受控故障注入 |

### 当前下一步

1. 重新编译并烧录当前源码，确认实际运行的固件确实包含“SafetyTask 启动后才开狗”。
2. 保存完整上电串口日志，重点查看 `RTOS create` 和是否重复出现 `PanView Pxx boot`。
3. 若仍有复位，再加入 RCC 复位标志日志，区分 IWDG、软件复位、上电复位和异常复位。
## 资料与代码依据

- `D:\工具资源\XCOM（正点原子推荐）\p11调试日志.txt`
- `firmware/stm32f407/PanViewF407/Core/Src/freertos.c`：互斥锁、心跳任务、视觉消息队列
- `firmware/stm32f407/PanViewF407/Core/Src/main.c`：`PanView_AppStep()`、TFT 刷新标记和控制状态
- `firmware/stm32f407/PanViewF407/Core/Inc/main.h`：`PanView_Uart1Transmit()` 与 RTOS 视觉消息接口声明
- `docs/00-project/project-based-learning-plan.md`：P11 目标为任务优先级、心跳、看门狗、遥测和安全故障路径
