jiang-zexuan/k230-42-stepper-vision-tracking-2d-gimbal/docs/05-learning-log/p01-f407-board-diagnostics-review.md

# P01：F407 板级诊断台复盘

- 日期：2026-08-15
- 阶段状态：实测通过。
- 工程：`firmware/stm32f407/PanViewF407/`

## 本项目解决的问题

P01 的目标不是实现复杂功能，而是建立后续所有 F407 工作依赖的最小闭环：能够生成工程、下载调试、控制一个输出、读取一个输入，并把关键状态送到 PC 串口。

## 已实测的结果

| 项目 | 结果 | 证据类型 |
| --- | --- | --- |
| ST-Link SWD 下载与调试 | 成功下载、校验；曾在 `main()` 和按键读取处断点，查看局部变量。 | 现场操作与 CubeIDE 控制台 |
| DS0 初始状态 | 初始化后熄灭。 | 现场观察 |
| KEY0 输入 | 未按下读为 `GPIO_PIN_SET`；按下读为 `GPIO_PIN_RESET`。 | 通过断点观察变量 |
| KEY0 控制 DS0 | 经下降沿识别和 20 ms 复查后，短按可切换 DS0。 | 现场观察 |
| USART1 启动日志 | 串口助手 `COM8` 显示 `PanView P01 boot`，RESET 后再次显示。 | 现场观察 |
| KEY0 串口事件 | 有效按下后显示 `KEY0 pressed`。 | 现场观察 |
| 周期心跳与计数器 | 固件每 500 ms 输出递增的 `heartbeat: <n>`；日志记录到 1300。 | 原始 XCOM 导出日志 |

## 代码到意图

| 代码或配置 | 它实现的意图 |
| --- | --- |
| CubeMX：SYS Debug = Serial Wire | 允许 ST-Link 通过 SWD 控制和调试芯片。 |
| PF9 输出、高电平初始 | DS0 为低有效，初始化为高电平可令其熄灭。 |
| PE4 输入、内部上拉 | 未按 KEY0 时稳定读取高电平；按下后读取低电平。 |
| `HAL_GPIO_ReadPin()` | 获取按键此刻的电平状态。 |
| `previous_key0_state` 与高到低判断 | 将“持续按住”转换为“一次按下事件”。 |
| `HAL_Delay(20)` 后复查 | 过滤机械按键在按下瞬间的抖动。 |
| `HAL_GPIO_TogglePin()` | 每个有效按下切换一次 DS0。 |
| `HAL_UART_Transmit()` | 将启动、按键和心跳状态输出给 PC，用于诊断。 |
| `HAL_GetTick()` 与时间差判断 | 到达 500 ms 周期时输出心跳，而非用 500 ms 延时阻塞主循环。 |

## 已理解的关键知识

1. HAL 没有改变外设开发的本质：仍是开时钟、配置 GPIO/外设、读写数据；它把寄存器细节封装为句柄和函数。
2. `main()` 的基本顺序是 `HAL_Init()`、时钟配置、`MX_GPIO_Init()`、`MX_USART1_UART_Init()`、用户应用逻辑。
3. GPIO 的输入和输出是两条不同方向的链路：按键电平进入 CPU，CPU 输出电平改变 LED。
4. USART1 到 PC 的实测链路是 F407 USART1 -> PA9 -> CH340C -> USB -> COM8。
5. `HAL_Delay()` 适合当前简单消抖，但它会阻塞 CPU；周期任务应以时间差判断为基础。这是 P02 的入口。
6. C 变量的作用域决定其可见范围；`current_tick` 必须在 `while` 循环内定义并在循环内使用，枚举项和变量不能重复定义。

## 复习自测

1. 为什么 KEY0 按下时是 `GPIO_PIN_RESET`，而不是 `GPIO_PIN_SET`？
2. 为什么“读到低电平就翻转 LED”会出现不可预测的结果？
3. `HAL_Delay(500)` 与使用 `HAL_GetTick()` 判断 500 ms 的核心区别是什么？
4. 为什么周期心跳可用于诊断复位或主循环卡死？
5. 为什么用户代码应放在 CubeMX 的 `USER CODE` 区域？

## 当前边界与下一步

- 原始日志为 XCOM 直接导出，保存于 `evidence/serial-logs/exp-0002-usart1.log`；SHA-256 为 `4C75308961B7E98995F8FFE2B3B9876DF47E84D7088A08F4E12E4355CA263273`。
- 日志包含 5 条启动消息、3 次计数重新从 `heartbeat: 1` 开始，以及 6 条 KEY0 事件；结合本轮 RESET 操作，记录为复位后重新启动的证据。
- P01 验收闭合后，进入 P02 的 10 ms、100 ms、500 ms 非阻塞任务。

## 资料依据

- `探索者V3 硬件参考手册_V1.0/full.md`：§1.1.2、§1.2.1、表 1.2.2.1、§2.1.3、§2.1.4。
- `docs/00-project/project-based-learning-plan.md`：P01 与 P02 的目标、验收和衔接。
