jiang-zexuan/k230-42-stepper-vision-tracking-2d-gimbal/docs/05-learning-log/p09-horizontal-visual-tracking-review.md

# P09：单轴视觉跟踪器复盘

- 日期：2026-08-23
- 分支：`feature/f407-p09-horizontal-visual-tracking`
- 阶段状态：水平视觉跟随、死区、比例速度、软件限位和无目标停机已实测；精确 300 ms 时延、错帧根因和置信度门槛待补测。
- 原始证据：`D:\工具资源\XCOM（正点原子推荐）\p09调试日志.txt`
- 原始证据 SHA-256：`91EB77025E1747F366E374C4574BB95ECADE0D248A59AE820A3DF2ABB50ACFEF`
- 仓库证据：`evidence/serial-logs/exp-0010-p09-horizontal-visual-tracking.log`

## 这一步做了什么

已把 P08 得到的 `err_x` 接入水平轴控制器。每收到一条有效 `PV04` 结果，先判断目标是否存在，再经过 40 px 死区、2 脉冲/px 比例和 800 脉冲/s 上限，生成带符号的 `pan_speed`。

已将 `pan_speed` 转换为 TIM4 的 STEP 频率。正速度使用已实测的水平正方向，负速度使用反方向；方向变化前先停止 STEP，再改变 DIR。TIM4 更新中断每产生一个周期，就向软件脉冲坐标提交一个正向或负向增量。

已加入水平软件边界 `-800~+800` 脉冲，对应当前 16 细分下的约 `-90°~+90°` 设计范围。下一脉冲会越界时停止输出，到达边界后保持 EN，避免继续向外运动。

已加入视觉结果超时保护：超过 300 ms 没有有效 K230 结果时停止水平 STEP；接管状态下仍保持 EN。按键、手动运动、双轴测试和视觉运动互斥，避免多个控制路径同时占用 TIM4。

## 为什么要学

视觉坐标只是“目标在哪里”，电机需要的是“向哪个方向、以多快速度、最多转到哪里”。P09 把通信、坐标误差、比例控制、定时器脉冲和安全停止串成第一条裸机视觉闭环，能够定位问题究竟出在视觉数据、控制计算还是执行机构。

## 实测结果

| 项目 | 实际结果 | 状态 |
| --- | --- | --- |
| P09 固件启动标识 | 最新会话输出 `PanView P09 boot` | 已实测 |
| 方向映射 | `err_x<0` 时 `pan_speed>0`；`err_x>0` 时 `pan_speed<0`，实物转动方向正确 | 已确认 |
| 死区 | 例如 `err_x=-18`、`-23`、`+6` 时 `pan_speed=0` | 已实测 |
| 比例和最大速度 | 例如 `err_x=-291` 时 `pan_speed=502`；大偏差时限制为 `800` | 已实测 |
| 水平软件限位 | 历次会话中 `pan_pos` 到达 `+800/-800` 后 `visual_run=0` | 已实测 |
| 无目标 | `target=0` 时 `pan_speed=0`、`visual_run=0` | 已实测 |
| 视觉 STEP 运行 | `visual_run=1` 时 `pan_pos` 持续变化 | 已实测 |
| K230 停止后的停机 | 已现场确认电机停止；串口汇总未记录精确停机时刻 | 功能已实测，精确 300 ms 待逻辑分析仪测量 |
| 最新会话接收统计 | `frames=1262`、`drop=0`、`text_ok=1256`、`text_err=6` | 已实测，少量错帧待定位 |
| 置信度门槛 | 当前 `confidence` 未进入结构化结果和控制判断 | 待实现 |

## 代码动作 -> 工程意图

| 代码动作 | 工程意图 | 大白话描述给 AI |
| --- | --- | --- |
| `VisualTrackController_HorizontalSpeed()` | 将画面误差变成受限速度目标 | “目标离中心远就快一点，进入死区就不动，速度不能超过上限。” |
| `VisualPan_ApplySpeed()` | 把带符号速度映射到 DIR 和 TIM4 频率 | “让水平电机按视觉方向转，换方向时先停脉冲。” |
| `HAL_TIM_PWM_Start()` | 输出水平 STEP 波形 | “开启定时器 PWM，让驱动器收到连续步进脉冲。” |
| `HAL_TIM_Base_Start_IT()` | 接收 TIM4 更新中断 | “每发出一个定时器周期，就记一枚软件脉冲并检查边界。” |
| `RelativePositionTracker_ApplyCompletedPulseDelta()` | 累计视觉运动的位置 | “每个已完成脉冲都更新软件坐标，不把目标速度直接当位置。” |
| `VISUAL_TARGET_TIMEOUT_MS` | 视觉数据断流后停止运动 | “超过 300 ms 没收到新结果，就立刻停止 STEP。” |
| `VisualPan_StopHardware()` | 停止脉冲、保持接管锁定 | “停止自动转动，但接管状态下继续使能电机，避免轴被手动带走。” |

## 关键 HAL 函数卡片

| 函数 | 本课用途 |
| --- | --- |
| `HAL_UARTEx_RxEventCallback()` | 接收 USART2 DMA/空闲事件提交的 K230 文本行。 |
| `HAL_GetTick()` | 记录最近有效视觉结果，判断 300 ms 超时。 |
| `HAL_TIM_PWM_Start()` / `HAL_TIM_PWM_Stop()` | 启停水平 STEP 输出。 |
| `HAL_TIM_Base_Start_IT()` / `HAL_TIM_Base_Stop_IT()` | 启停 TIM4 更新中断，用于脉冲坐标和限位检查。 |
| `HAL_GPIO_WritePin()` | 设置水平 DIR 和 EN 电平。 |

## 复习要点

1. `pan_speed` 是速度目标，不是位置；位置必须由已完成 STEP 脉冲累计得到。
2. 死区用于避免目标在中心附近时频繁正反换向。
3. 方向切换必须先停 STEP，再改 DIR，避免驱动器把方向变化误认为异常脉冲。
4. 软件限位检查的是“下一枚脉冲”，因此不会主动越过 `-800/+800`。
5. 无目标和通信超时都必须停止运动，不能沿用上一帧速度。
6. `visual_run=0` 可能表示死区、目标丢失、超时或软件限位；后续可增加停止原因字段。

## 尚未完成

- 用逻辑分析仪同时观察 PB6 STEP 和停止 K230 的时刻，给出 300 ms 内停机的波形证据。
- 保存并分析一条 `text_err` 错帧的原始字节，确认是输出格式、DMA 分段还是线路干扰。
- 将有效置信度纳入 `VisionTextResult` 和控制门槛；当前资料和实测尚未形成可靠阈值。
- P10 再加入俯仰误差和 `SEARCH/TRACKING/LOCKED/LOST/FAULT` 状态。
