jiang-zexuan/k230-42-stepper-vision-tracking-2d-gimbal/docs/00-project/learning-map.md

# 学习地图

学习顺序是：嵌入式 C 基础与外设驱动，裸机运动控制，K230 视觉与串口协议，单轴再双轴跟踪，FreeRTOS 工程化，最后进行模型、容错和测试交付。

每次学习都应对应一个可观测的小产出：串口日志、示波器或逻辑分析仪证据、短视频、测试报告或可复现实验记录。先建立证据，再归纳结论。
