jiang-zexuan/k230-42-stepper-vision-tracking-2d-gimbal/hardware/datasheets/yahboom-k230-standard/K230视觉模块-标准版_4.jpg

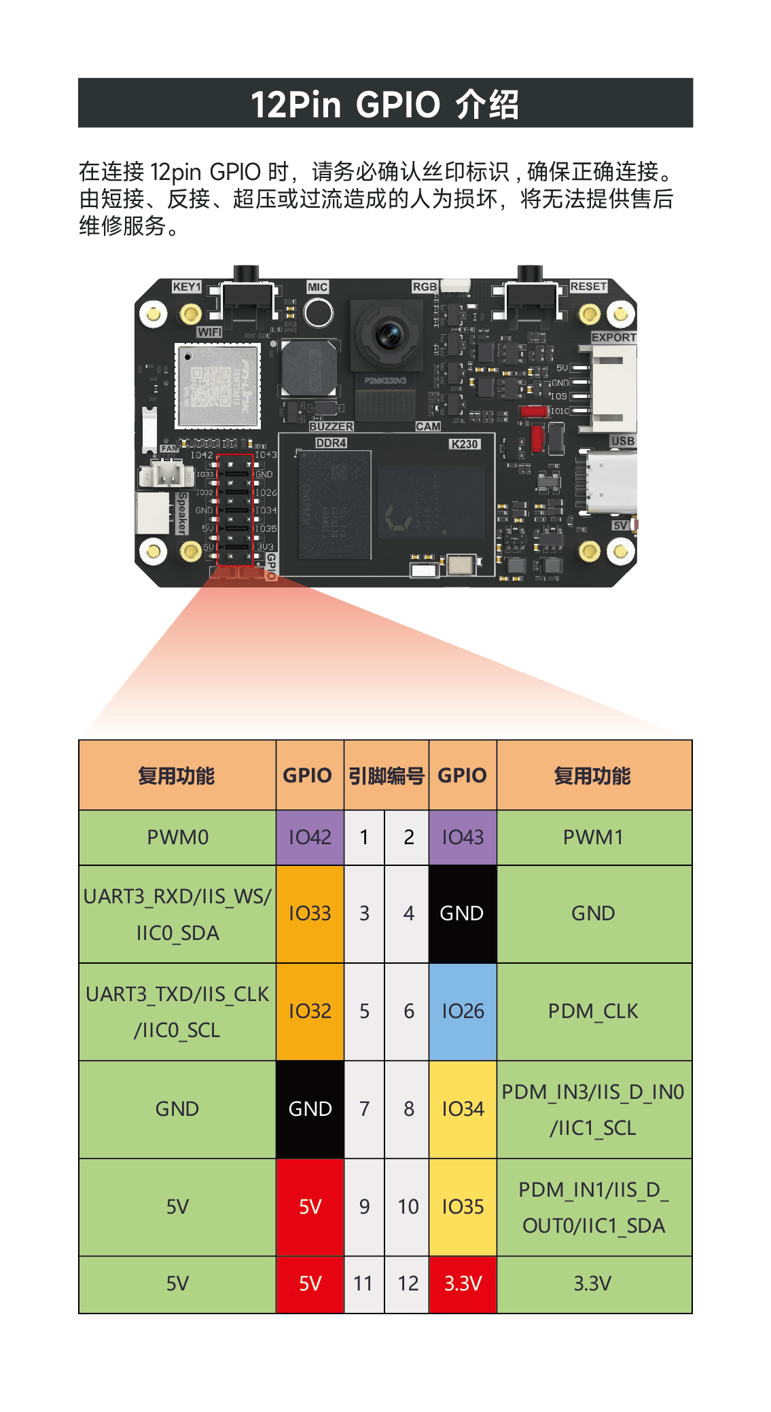
hardware/datasheets/yahboom-k230-standard/K230视觉模块-标准版_4.jpg
