jiang-zexuan/k230-42-stepper-vision-tracking-2d-gimbal/hardware/bom/bom.md

# 物料清单

| 类别 | 器件 | 数量 | 状态 | 说明 |
| --- | --- | --- | --- | --- |
| 控制器 | 正点原子 STM32F407 探索者 | 1 | 已有 | 板级资料与准确版本待核验。 |
| 视觉 | Yahboom AIMOTION2 K230 标准版 | 1 | 已有 | 原始说明图见 datasheets。 |
| 预研驱动 | TB6612FNG | 1 | 已有 | 仅用于早期基础换相实验，不用于最终步进驱动。 |
| 执行器 | X42S 42 系列闭环步进电机/驱动器组合，1.8° | 2 | 已有 | 驱动器内置磁编码器与 FOC 闭环。 |
| 控制信号 | STEP / DIR / EN 三路逻辑控制线 | 2 轴 | 已接入 | 由 F407 定时器/GPIO 输出，分别控制两台 X42S。 |
| 通信链路 | TTL UART（X42S 反馈诊断、K230-F407 专用 UART） | 2 路 | 已验证 | K230 使用 TX/RX/5V/GND 四线接口；逻辑地共地。 |
| 机械 | 成品双轴云台及线束 | 1 | 已有 | 水平、俯仰软件限位均按最终方案为 ±90°。 |
| 电源 | 12 V 可调限流电源 | 1 | 已有 | 仅供两台电机/驱动器；F407 与 K230 逻辑电源独立。 |
| 光学指示 | 受控光学指示模块（PF10 控制，模块自带限流） | 1 | 已有 | 命中音效期间开启，音效结束或安全停止时关闭。 |
| 显示与触摸 | 2.8 英寸 SPI TFT（ILI9341 类）/ FT6336G | 1 | 已有 | F407 显示状态、运行时间和目标误差。 |
| 音频 | ES8388 音频模块与扬声器 | 1 | 已有 | 仅播放命中特效音。 |
