jiang-zexuan/k230-42-stepper-vision-tracking-2d-gimbal/hardware/wiring/README.md

# 接线记录

这里存放经过实测确认的接线图、照片和端子定义。设计草案见 docs/02-architecture/power-and-wiring.md，它不是可直接上电的接线指令。

每次改变接线都应建立实验记录，并注明开发板版本、模块版本、供电方式与证据照片。
