jiang-zexuan/k230-42-stepper-vision-tracking-2d-gimbal/docs/02-architecture/power-and-wiring.md

# 供电与接线

## 设计基线，未上电验证

| 子系统 | 计划供电 | 说明 |
| --- | --- | --- |
| K230 标准版 | 自身 5 V USB | 使用模块原装或经核验的供电方式。 |
| STM32F407 开发板 | USB | 仅用于第一阶段板级自检和逻辑供电。 |
| 两台 X42S 闭环步进组合 | 独立 12 V 可调限流电源 | 电机电源与 F407/K230 逻辑电源分开，按 X42S 手册设置电流。 |

## 强制核对项

- 所有进行 UART 或 STEP/DIR 通信的设备必须共地。
- 不得把 12 V 电机电源接入 F407 的 5 V 或 3.3 V 引脚。
- 在接电前核对 X42S 的电源端子、STEP/DIR/EN 电平和电机接口定义。
- K230 与 F407 通过模块专用 TX/RX/5V/GND 四线接口连接，通信前确认共地和电平兼容。
- 水平全行程测试应低速进行，并确认线束不会拉扯、挤压或缠绕。
