jiang-zexuan/k230-42-stepper-vision-tracking-2d-gimbal/docs/06-experiments/EXP-0003-p02-nonblocking-timed-tasks.md

# EXP-0003：P02 非阻塞定时任务台

## 基本信息

- 实验编号：EXP-0003
- 目标：验证 10 ms 按键扫描、100 ms 状态任务、500 ms 心跳任务可在同一裸机主循环中运行，且按键消抖不阻塞主循环。
- 日期：2026-08-15
- 状态：实测通过。

## 硬件与接线

- 硬件版本：探索者 V3.2，STM32F407ZGT6。
- 调试：外置 ST-Link SWD。
- 串口：板载 CH340C，`COM8`，115200 bit/s、8N1、无流控。

## 固件与配置

- 固件提交：`0afd250`。
- 配置：KEY0 10 ms 扫描、20 ms 非阻塞消抖；100 ms 状态任务；500 ms 心跳任务。
- 日志格式：`t=<ms> dt=<ms> heartbeat=<n> scans=<n> status=<n>`。

## 操作与结果

1. 构建并下载固件，打开 XCOM 观察心跳。
   - 预期：`dt` 接近 500 ms，扫描与状态计数按 50:5 比例增长。
   - 实际：226 条 P02 格式样本的 `dt` 最小、最大、平均值均为 500 ms；每条心跳的扫描和状态计数分别增加 50 与 5。
2. 在持续输出期间短按和按住 KEY0。
   - 预期：每次有效按下只产生一次事件，DS0 切换，心跳不断流。
   - 实际：日志包含 6 条 `KEY0 pressed`；已确认 DS0 每次只切换一次。

## 证据与结论

- 原始证据：`evidence/serial-logs/exp-0003-p02-timed-tasks.log`。
- SHA-256：`818876F1D841454D5982B3F92EFD09E99E099B52FC79689996A3C525F881E9F8`。
- 说明：日志开头保留 P01 历史输出；统计只匹配 P02 的 `t=... dt=...` 格式行。
- 结论：P02 的三种周期任务和非阻塞消抖在本轮板上实测通过。
- 下一步：P03 UART DMA 协议实验器。
