jiang-zexuan/k230-42-stepper-vision-tracking-2d-gimbal/docs/06-experiments/EXP-0009-p08-k230-f407-link.md

# EXP-0009：P08 K230-F407 视觉通信链路

## 基本信息

- 实验编号：EXP-0009
- 日期：2026-08-23
- 状态：文本过渡链路和视觉误差计算已实测；正式二进制协议待完成。
- 分支：`feature/f407-p08-k230-link`

## 目标

验证 K230 标准版专用通信口到 F407 USART2 的接线、DMA 分段接收、文本行拼接、视觉字段解析、画面中心误差和水平速度目标计算。

## 硬件与接线

依据 K230 标准版接口资料和已确认接线：

```text
K230 IO9 / TX1  -> F407 PA3 / USART2_RX
K230 IO10 / RX1 <- F407 PA2 / USART2_TX
K230 GND        -> F407 GND
```

K230 运行 `firmware/k230/app/p04_face_result_publisher.py`，F407 使用 USART2 115200、8N1、RX DMA Normal、Receive-to-Idle。

## 操作与结果

1. 初次下载后保持 K230 未运行：`frames=0`，F407 主循环和诊断日志正常。
2. 运行 K230 P04 发布器：`frames` 持续增加，`cx/cy` 随目标变化。
3. 观察 DMA 分段：出现 `last_size=6/15/35` 等短片段，确认不能把 DMA 回调直接当完整文本帧。
4. 加入按换行拼行后重新实测：`frames=837`、`drop=0`、`text_ok=828`、`text_err=9`。
5. 无目标时观察到 `target=0` 且误差与速度目标清零。
6. 目标偏左/偏右时观察 `err_x` 正负和 `pan_speed` 正负，方向映射按实测结果取反。
7. 使用 Logic 2 在 F407 PA3/USART2_RX 端采样，第二次采样持续约 19.6 s，解码得到 555 条完整 `PV04` 行，未出现 `0xFF`。

## 自动化验证

```text
uart_text_line_accumulator_test: PASS
vision_text_result_parser_test: PASS
vision_error_test: PASS
visual_track_controller_test: PASS
K230 Python tests: Ran 8 tests, OK
Keil: Rebuild 0 errors, 0 warnings
```

## 结论

文本过渡链路已达到“可接收、可拼行、可解析、可计算误差”的阶段目标。该实验不宣称 P08 正式二进制协议已完成，也不宣称视觉已经驱动电机。

## 证据

- 原始日志：`D:\工具资源\XCOM（正点原子推荐）\p08调试日志.txt`
- SHA-256：`2EF7443C709BE7EB6CFA83317BCB984020EB2A786E57A49AE35C4E7BDBE86985`
- 逻辑分析仪 CSV：`C:\Users\a7864\Desktop\1.csv`
- 逻辑分析仪 CSV SHA-256：`E9BBCD1F3157C63774EAE496FCB34210FC86728B8518A7F214610A28E7679201`
- 相关资料：`D:\datasheet-knowledge\parsed\K230视觉模块-标准版\full.md`
