jiang-zexuan/k230-42-stepper-vision-tracking-2d-gimbal/docs/06-experiments/index.md

# 实验索引

| 实验编号 | 标题 | 日期 | 状态 | 证据 |
| --- | --- | --- | --- | --- |
| EXP-0001 | 仓库与资料基线检查 | 2026-08-13 | 文档记录，非硬件实测 | Git 提交与资料索引 |
| EXP-0002 | P01 F407 板级诊断台 | 2026-08-15 | 实测通过 | `docs/06-experiments/EXP-0002-f407-board-bringup.md` |
| EXP-0003 | P02 非阻塞定时任务台 | 2026-08-15 | 实测通过 | `docs/06-experiments/EXP-0003-p02-nonblocking-timed-tasks.md` |
| EXP-0004 | P03 UART DMA 协议实验器 | 2026-08-16 | 实测通过 | `docs/06-experiments/EXP-0004-p03-uart-dma-protocol.md` |
| EXP-0005 | P04 K230 视觉结果发布器 | 2026-08-16 | 实测通过（置信度字段不可用） | `docs/06-experiments/EXP-0005-p04-k230-vision-result-publisher.md` |
| EXP-0006 | P05 单轴闭环电机验收台 | 2026-08-21 | 板上实测通过；波形和温度数值待补测 | `docs/06-experiments/EXP-0006-p05-single-axis-pulse-lab.md` |
| EXP-0007 | P06 水平轴软件限位 | 2026-08-21 | 软件测试和 ARM 编译通过；板上行为待验证 | `docs/06-experiments/EXP-0007-p06-horizontal-motion-limits.md` |
| EXP-0008 | P07 双轴云台基础控制器 | 2026-08-22 | 双轴板上实测通过 | `docs/06-experiments/EXP-0008-p07-dual-axis-controller.md` |
| EXP-0009 | P08 K230-F407 视觉通信链路 | 2026-08-23 | 文本过渡链路和误差计算已实测；二进制协议待完成 | `docs/06-experiments/EXP-0009-p08-k230-f407-link.md` |
| EXP-0010 | P09 单轴视觉跟踪器 | 2026-08-23 | 水平跟随和安全停机已阶段性实测；精确时延、错帧根因和置信度门槛待补测 | `docs/06-experiments/EXP-0010-p09-horizontal-visual-tracking.md` |

新增实验后在此登记，并创建独立实验记录文件。
