jiang-zexuan/k230-42-stepper-vision-tracking-2d-gimbal/docs/07-test/TEST-0008-p08-k230-f407-link.md

# TEST-0008：P08 K230-F407 视觉通信链路测试报告

- 测试编号：TEST-0008
- 日期：2026-08-23
- 分支：`feature/f407-p08-k230-link`

| 测试项 | 实际结果 | 状态 |
| --- | --- | --- |
| USART2 DMA 接收 | K230 运行后 `frames=837` | 通过 |
| 邮箱丢弃 | `drop=0` | 通过 |
| 文本行拼接 | DMA 半段合并后可提交完整行 | 通过 |
| 文本结果解析 | `text_ok=828`；`text_err=9` | 通过，少量错帧待定位 |
| 无目标处理 | `target=0`、误差和速度均为 0 | 通过 |
| 画面中心误差 | `(960,540)` 对应零误差 | 通过 |
| 死区 | ±40 px 内速度为 0 | 通过 |
| 比例与限速 | 速度按比例生成并限制在 ±800 | 通过 |
| 方向映射 | 画面左侧为正，右侧为负 | 已确认 |
| Keil 构建 | 0 errors, 0 warnings | 通过 |
| 逻辑分析仪复测 | 19.6 s 内解码 555 条，全部符合 PV04 行格式，`0xFF=0` | 通过 |

## 已知限制

- 当前仍是 P04 文本过渡格式，不是规划中的正式二进制协议。
- 第一次逻辑采样曾发现 1 个 `0xFF` 异常字节；第二次采样未复现，原因暂不确定，不能归因于 K230 或 F407 软件。
- 视觉结果尚未接入水平电机，P09 的真实运动安全验收尚未开始。

## 原始证据

- `D:\工具资源\XCOM（正点原子推荐）\p08调试日志.txt`
- SHA-256：`2EF7443C709BE7EB6CFA83317BCB984020EB2A786E57A49AE35C4E7BDBE86985`
- Logic 2 CSV：`C:\Users\a7864\Desktop\1.csv`
- Logic 2 CSV SHA-256：`E9BBCD1F3157C63774EAE496FCB34210FC86728B8518A7F214610A28E7679201`
