jiang-zexuan/k230-42-stepper-vision-tracking-2d-gimbal/scripts/test-tools/README.md

# 测试工具

后续存放串口回放、参数采集、日志整理和报告辅助工具。工具本身不替代原始证据，原始串口日志和截图应保存在 evidence/。
