jiang-zexuan/k230-42-stepper-vision-tracking-2d-gimbal/docs/07-test/TEST-0014-t13-end-to-end-closeout.md

# T13/T14 端到端联调与工程收尾记录

## 日期

2026-09-04

## 实测结论

用户已完成整机回归测试。K230 视觉结果可以经过 VisionRxTask、MotionTask 和 StepperTask 驱动双轴运动；UI 触摸 START/STOP、HIT 状态、命中音效和 PF10 指示灯均已验证。SafetyTask 的故障停机、软件限位、看门狗和栈监测保持有效。

## T14 清理内容

- 新工程使用 FreeRTOS 分任务链路，不依赖旧工程的 `PanView_AppStep()` 集中式入口。
- 周期性 `VISION_NEW`、`T07`、`PV05_OK` 调试输出已关闭，统一由 T12 遥测输出。
- 旧工程目录继续保留，仅作为历史参考，不参与新工程编译。
- 当前分支保留为 `feature/freertos-rearchitecture`，不合并到 `main`。

## 最终验证

- CMake Debug 构建通过。
- 实机完成启动、零点确认、跟踪、命中、音效、指示灯、停止和安全状态测试。
- 最终代码已推送到 GitHub。
