jiang-zexuan/k230-42-stepper-vision-tracking-2d-gimbal/docs/06-experiments/EXP-0008-p07-dual-axis-controller.md

# EXP-0008：P07 双轴云台基础控制器

## 基本信息

- 实验编号：EXP-0008
- 日期：2026-08-22
- 状态：双轴板上实测通过。
- 固件分支：`feature/f407-p07-dual-axis-controller`

## 实验目标

验证两台 X42S 的独立控制、人工归中接管、俯仰 ±45° 软件限位，以及双轴正反向同步运动。

## 关键配置

| 轴 | STEP | DIR | EN | 软件范围 |
| --- | --- | --- | --- | --- |
| 水平 | PB6 / TIM4_CH1 | PB7 | PG15 | -90°~+90°（±800 脉冲） |
| 俯仰 | PC9 / TIM3_CH4 | PC8 | PC7 | -45°~+45°（±400 脉冲） |

两台电机均使用当前已确认的 16 细分配置，即 3200 脉冲/圈。复位后 EN 失能，按 KEY_UP 后进入软件接管态。

## 操作与结果

1. 复位后手动调整两个轴：通过。
2. 手动归中后按 KEY_UP，两个轴锁定：通过。
3. 修正俯仰 DIR 映射后，PITCH_UP/PITCH_DOWN 方向正确：通过。
4. 俯仰正方向连续 4 次 100 脉冲后，第 5 次被 ±45°限位拒绝：通过。
5. 俯仰负方向限位测试：通过。
6. DUAL_TEST 正向联动连续 4 次，第 5 次整体拒绝：通过。
7. DUAL_TEST_NEG 反向联动和负方向限位：通过。
8. 心跳日志间隔实测为 5000 ms，按键扫描和状态任务计数正常：通过。

## 结论

双轴执行机构已经具备人工回中、软件接管、独立运动、同步运动和软件限位能力，可以进入 P08 K230-F407 正式通信链路。当前未接入视觉闭环，也未把脉冲理论坐标当作绝对位置。
