jiang-zexuan/k230-42-stepper-vision-tracking-2d-gimbal/docs/07-test/TEST-0002-p02-nonblocking-timed-tasks.md

# TEST-0002：P02 非阻塞定时任务台测试报告

- 测试编号：TEST-0002
- 对应需求：REQ-011
- 日期：2026-08-15
- 固件提交：`0afd250`。
- 配置：KEY0 10 ms 扫描、20 ms 非阻塞消抖；100 ms 状态任务；500 ms 心跳任务。

| 测试项 | 实际结果 | 状态 |
| --- | --- | --- |
| 周期任务单元测试 | `periodic_task_test: PASS`。 | 通过 |
| 消抖单元测试 | `debounced_button_test: PASS`。 | 通过 |
| 500 ms 实际周期 | 226 条样本均为 500 ms。 | 通过 |
| 10/100 ms 相对频率 | 每个心跳周期内扫描/状态计数各增加 50/5。 | 通过 |
| 按键与心跳并行 | 日志有 6 条事件且心跳持续；DS0 行为已现场确认。 | 通过 |

## 证据

- 原始串口日志：`evidence/serial-logs/exp-0003-p02-timed-tasks.log`。
- 实验记录：`docs/06-experiments/EXP-0003-p02-nonblocking-timed-tasks.md`。

## 结论

REQ-011 测试通过。当前实现为协作式裸机周期调度，尚未引入中断任务或 FreeRTOS 调度器。
