jiang-zexuan/k230-42-stepper-vision-tracking-2d-gimbal/docs/07-test/TEST-0007-p07-dual-axis-controller.md

# TEST-0007：P07 双轴云台基础控制器测试报告

- 测试编号：TEST-0007
- 日期：2026-08-22
- 分支：`feature/f407-p07-dual-axis-controller`

| 测试项 | 实际结果 | 状态 |
| --- | --- | --- |
| 复位后两轴手动调整 | 两台电机均失能，可手动转动 | 通过 |
| KEY_UP 接管 | 两轴记录零点并保持使能 | 通过 |
| 俯仰方向 | PITCH_UP 向上，PITCH_DOWN 向下 | 通过 |
| 俯仰正向 ±45°限位 | 第 5 个 100 脉冲命令被拒绝 | 通过 |
| 俯仰负向 ±45°限位 | 反向外向命令被拒绝 | 通过 |
| 双轴正向同步 | 两轴各 100 脉冲，同时启动和停止 | 通过 |
| 双轴反向同步 | DUAL_TEST_NEG 通过 | 通过 |
| 双轴越界原子拒绝 | 俯仰越界时水平不单独运动 | 通过 |
| 心跳和周期任务 | 心跳 5000 ms，扫描约 10 ms，状态约 100 ms | 通过 |

## 已知限制

- 软件坐标依赖人工回中，不能替代绝对编码器归零或机械限位开关。
- 全行程机械干涉、线束余量和长期温升仍需在装配状态下单独观察。
- K230 视觉闭环尚未接入，P08 继续验证正式通信链路。
