jiang-zexuan/k230-42-stepper-vision-tracking-2d-gimbal/docs/07-test/TEST-0009-p09-horizontal-visual-tracking.md

# TEST-0009：P09 单轴视觉跟踪器测试报告

- 测试编号：TEST-0009
- 日期：2026-08-23
- 分支：`feature/f407-p09-horizontal-visual-tracking`

| 测试项 | 实际结果 | 状态 |
| --- | --- | --- |
| P09 固件启动 | `PanView P09 boot` | 通过 |
| 目标偏左/偏右 | `err_x<0` 产生正速度，`err_x>0` 产生负速度；实物方向正确 | 通过 |
| 死区 | `abs(err_x)<=40` 时 `pan_speed=0` | 通过 |
| 比例控制 | 误差增大时速度按比例增加 | 通过 |
| 最大速度 | 输出限制在 `-800~+800` 脉冲/s | 通过 |
| 视觉 STEP | `visual_run=1` 时 `pan_pos` 持续变化 | 通过 |
| 水平软件限位 | 到达 `-800/+800` 后停止外向 STEP | 通过 |
| 无目标停机 | `target=0`、`pan_speed=0`、`visual_run=0` | 通过 |
| K230 停止后的功能停机 | 现场确认电机停止 | 通过；精确时延待测 |
| 最新会话通信统计 | `frames=1262`、`drop=0`、`text_ok=1256`、`text_err=6` | 通过；错帧待定位 |
| 300 ms 精确时延 | 当前串口每秒汇总，无法给出毫秒级证据 | 待验证 |
| 最小置信度门槛 | 当前未接入控制判断 | 待实现 |

## 已知限制

- `pan_pos` 是 F407 软件脉冲坐标，不是 X42S 磁编码器的绝对反馈。
- 没有逻辑分析仪波形时，不能把串口日志中的“停止”写成精确 300 ms。
- `text_err` 已统计但尚未保存对应原始错帧，根因不确定。
- 当前只控制水平轴，俯仰轴视觉跟随属于 P10。

## 原始证据

- `D:\工具资源\XCOM（正点原子推荐）\p09调试日志.txt`
- SHA-256：`91EB77025E1747F366E374C4574BB95ECADE0D248A59AE820A3DF2ABB50ACFEF`
- 仓库副本：`evidence/serial-logs/exp-0010-p09-horizontal-visual-tracking.log`
