jiang-zexuan/k230-42-stepper-vision-tracking-2d-gimbal/docs/07-test/TEST-0010-p10-f407-tft-pure-color.md

# TEST-0010：P10 F407 TFT 纯色诊断测试报告

- 测试编号：TEST-0010
- 日期：2026-08-23
- 分支：`feature/f407-p10-dual-axis-visual-tracking`

| 测试项 | 实际结果 | 状态 |
| --- | --- | --- |
| F407 SPI1 初始化 | 工程构建并运行 | 通过 |
| 命令/数据 DC 切换 | Logic 2 已确认 | 通过 |
| RGB565 红色 `0xF800` | 屏幕显示红色 | 通过 |
| RGB565 绿色 `0x07E0` | 屏幕显示绿色 | 通过 |
| RGB565 蓝色 `0x001F` | 屏幕显示蓝色 | 通过 |
| 完整 ILI9341 初始化 | 三色显示均正确 | 通过 |
| TFT ID 读取 | `00 00 00 0F`，无可用型号信息 | 不确定，不作为验收条件 |

## 验收结论

P10 的 TFT 纯色诊断通过。当前可以进入英文数字和状态文本显示；中文点阵和视觉状态仪表盘尚未开始。

## 证据

- Logic 2 导出：`C:\Users\a7864\Desktop\11.csv`
- 原始问题记录：`docs/08-debug/ISSUE-0011-tft-color-mismatch.md`
- 当前驱动：`firmware/stm32f407/PanViewF407/Core/Src/ili9341.c`
