jiang-zexuan/k230-42-stepper-vision-tracking-2d-gimbal/CHANGELOG.md

# 变更日志

本项目按 Keep a Changelog 的思想记录对学习、设计和实现有影响的变化。没有实测证据的事项不得标注为“修复”或“稳定”。

## [Unreleased]

### 项目收尾与公开展示

- 整理整机、控制台、目标跟踪与最终装配的实物照片，以及一段演示视频，统一存放于 `docs/assets/` 并在 README 展示。
- 将 CubeMX 生成的本地 HAL、CMSIS 与 FreeRTOS 依赖纳入工程，Keil 工程改用仓库内相对路径，降低在另一台电脑上打开工程时对本机 Cube 固件包路径的依赖。
- 命中状态增加普通光线指示模块：F407 的 PF10 在命中提示音播放期间输出有效电平，音效结束、停止、故障和复位时关闭。

### P11 收尾：FreeRTOS 与故障管理

- 已将控制、视觉队列、遥测、TFT 状态刷新、触摸输入和安全检查拆为独立 RTOS 任务。
- 已加入 USART1 发送互斥、任务心跳、栈余量和任务创建状态遥测。
- 已加入视觉超时、控制任务失活和软件限位安全停机路径。
- 已接入 IWDG；现场发现并修复 FreeRTOS heap 不足导致任务创建失败、进而触发看门狗复位循环的问题。
- 最新现场日志证明六个业务任务和两个消息队列创建成功，心跳连续运行，屏幕不再反复重启。
- P11 复盘见 `docs/05-learning-log/p11-freertos-fault-management-review.md`。

### P12 入口

- P12 后续以自定义模型、模型部署、故障注入、长时间运行和作品集交付为附加内容推进。

### P12 附加内容：自定义模型与 TFT 控制台

- 接入自定义目标识别模型，保留 K230 -> USART2 DMA -> F407 视觉误差解析链路。
- 重做 TFT 运行主页，保留状态、运行时间、目标 X/Y 误差、启动/停止和 `Designed by JZX`。
- 增加四种主题色和触摸切换，启动/停止按钮提供按下反馈。
- 将俯仰软件限位调整为 ±90°，水平软件限位保持 ±90°。
- 锁定保持时间调整为 250 ms，锁定退出死区调整为 ±60 像素，以降低检测框抖动造成的反复启停。
- 增加 K230 DMA 启动和错误恢复诊断；本轮最新现场日志尚未归档，不能把旧日志标记为新的硬件验收证据。
- P12 复盘见 `docs/05-learning-log/p12-custom-model-and-ui-review.md`。

### 已验证

- P06 单轴运动控制器完成板上实测：人工回中、水平轴 ±90° 软件限位、两侧越界拒绝、边界反向返回、梯形加减速和 X42S TTL 闭环反馈均已留存原始串口证据；运动反馈误差最大约 0.68°，停止后为 0.00°。
- P05 单轴闭环电机验收台完成板上实测：STEP/DIR/EN 启停、方向、800 脉冲固定运动、加减速、人工理论零点和位置失效保护均已验证；STEP 波形和温度数值待仪器补测。
- P03 UART DMA 协议实验器在 PC 模拟发送端与 F407 板端完成实测：文本命令、流式二进制组帧、CRC 错帧恢复、通信超时与序号统计均已留存原始串口证据。
- P04 K230 视觉结果发布器完成实测：人脸检测结果、无目标状态、坐标、FPS 和 UART3 文本输出经 CH340/XCOM 留存原始证据；模型结果未暴露数值置信度，已标记为 `confidence=unavailable`。

### 已建立

- 项目目录、文档模板、K230 标准版原始说明图索引与项目协作约束。
- F407 与 K230 的初始接口和安全设计基线，均待硬件验证。
- P06 当前装配决策：水平轴因线束约束采用 ±90° 软件限位，俯仰轴数值范围待核验。
- `motion_limits` 纯逻辑限位模块及其主机测试已建立；板上拒绝越界行为待验证。
