jiang-zexuan/k230-42-stepper-vision-tracking-2d-gimbal/docs/08-debug/troubleshooting.md

# 调试手册

## 原则

先复现、留证和缩小范围，再修改。不能凭单次现象认定根因。

## 常见检查顺序

1. 确认供电电压、电流限制和所有设备的共地。
2. 核对模块丝印、开发板原理图和引脚复用，而非只看网络图片。
3. 用串口日志或逻辑分析仪确认帧头、长度、CRC 与时间间隔。
4. 先脱离电机验证 STEP/DIR 波形，再低速接入电机。
5. 发生位置异常后人工回中，不能相信无编码器系统的旧位置估算。

## 当前问题记录

- [ISSUE-0011：ILI9341 TFT 纯色显示异常](ISSUE-0011-tft-color-mismatch.md)
