jiang-zexuan/k230-42-stepper-vision-tracking-2d-gimbal/firmware/stm32f407/PanViewFreeRTOS/Core/Inc/main.h

#define BOARD_KEY2_Pin GPIO_PIN_2
#define BOARD_KEY2_GPIO_Port GPIOE
#define BOARD_KEY1_Pin GPIO_PIN_3
#define BOARD_KEY1_GPIO_Port GPIOE
#define BOARD_KEY0_Pin GPIO_PIN_4
#define BOARD_KEY0_GPIO_Port GPIOE
#define CTP_RST_Pin GPIO_PIN_5
#define CTP_RST_GPIO_Port GPIOE
#define CTP_INT_Pin GPIO_PIN_6
#define CTP_INT_GPIO_Port GPIOE
#define TFT_LCD_CS_Pin GPIO_PIN_13
#define TFT_LCD_CS_GPIO_Port GPIOC
#define BOARD_STATUS_LED_Pin GPIO_PIN_9
#define BOARD_STATUS_LED_GPIO_Port GPIOF
#define HIT_INDICATOR_Pin GPIO_PIN_10
#define HIT_INDICATOR_GPIO_Port GPIOF
#define BOARD_KEY_UP_Pin GPIO_PIN_0
#define BOARD_KEY_UP_GPIO_Port GPIOA
#define TFT_LCD_DC_Pin GPIO_PIN_5
#define TFT_LCD_DC_GPIO_Port GPIOA
#define TFT_LCD_RST_Pin GPIO_PIN_6
#define TFT_LCD_RST_GPIO_Port GPIOA
#define TFT_LCD_BL_Pin GPIO_PIN_15
#define TFT_LCD_BL_GPIO_Port GPIOB
#define PITCH_EN_Pin GPIO_PIN_7
#define PITCH_EN_GPIO_Port GPIOC
#define PITCH_DIR_Pin GPIO_PIN_8
#define PITCH_DIR_GPIO_Port GPIOC
#define MOTOR_EN_Pin GPIO_PIN_15
#define MOTOR_EN_GPIO_Port GPIOG
#define MOTOR_DIR_Pin GPIO_PIN_7
#define MOTOR_DIR_GPIO_Port GPIOB
