jiang-zexuan/k230-42-stepper-vision-tracking-2d-gimbal/firmware/stm32f407/PanViewFreeRTOS/App/Src/hit.c

#include <stdint.h>

const uint16_t hit_audio[35314] = {
  0x0000U, 0x0000U, 0x0000U, 0x0000U, 0x0000U, 0x0000U, 0x0000U, 0x0000U, 0x0000U, 0x0000U, 0x0000U, 0x0000U,
  0x0000U, 0x0000U, 0x0000U, 0x0000U, 0x0000U, 0x0000U, 0x0000U, 0x0000U, 0x0000U, 0x0000U, 0x0000U, 0x0000U,
  0x0000U, 0x0000U, 0x0000U, 0x0000U, 0x0000U, 0x0000U, 0x0000U, 0x0000U, 0x0000U, 0x0000U, 0x0000U, 0x0000U,
  0x0000U, 0x0000U, 0x0000U, 0x0000U, 0x0000U, 0x0000U, 0x0000U, 0x0000U, 0x0000U, 0x0000U, 0x0000U, 0x0000U,
  0x0000U, 0x0000U, 0x0000U, 0x0000U, 0x0000U, 0x0000U, 0x0000U, 0x0000U, 0x0000U, 0x0000U, 0x0000U, 0x0000U,
  0x0000U, 0x0000U, 0x0000U, 0x0000U, 0x0000U, 0x0000U, 0x0000U, 0x0000U, 0x0000U, 0x0000U, 0x0000U, 0x0000U,
  0x0000U, 0x0000U, 0x0000U, 0x0000U, 0x0000U, 0x0000U, 0x0000U, 0x0000U, 0x0000U, 0x0000U, 0x0000U, 0x0000U,
  0x0000U, 0x0000U, 0x0000U, 0x0000U, 0x0000U, 0x0000U, 0x0000U, 0x0000U, 0x0000U, 0x0000U, 0x0000U, 0x0000U,
  0x0000U, 0x0000U, 0x0000U, 0x0000U, 0x0000U, 0x0000U, 0x0000U, 0x0000U, 0x0000U, 0x0000U, 0x0000U, 0x0000U,
  0x0000U, 0x0000U, 0x0000U, 0x0000U, 0x0000U, 0x0000U, 0x0000U, 0x0000U, 0x0000U, 0x0000U, 0x0000U, 0x0000U,
  0x0000U, 0x0000U, 0x0000U, 0x0000U, 0x0000U, 0x0000U, 0x0000U, 0x0000U, 0x0000U, 0x0000U, 0x0000U, 0x0000U,
  0x0000U, 0x0000U, 0x0000U, 0x0000U, 0x0000U, 0x0000U, 0x0000U, 0x0000U, 0x0000U, 0x0000U, 0x0000U, 0x0000U,
  0x0000U, 0x0000U, 0x0000U, 0x0000U, 0x0000U, 0x0000U, 0x0000U, 0x0000U, 0x0000U, 0x0000U, 0x0000U, 0x0000U,
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
  0x0000U, 0x0000U, 0x0000U, 0x0000U, 0x0000U, 0x0000U, 0x0000U, 0x0000U, 0x0000U, 0x0000U, 0x0000U, 0x0000U,
  0x0000U, 0x0000U, 0x0000U, 0x0000U, 0x0000U, 0x0000U, 0x0000U, 0x0000U, 0x0000U, 0x0000U, 0x0000U, 0x0000U,
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
};
