jiang-zexuan/k230-42-stepper-vision-tracking-2d-gimbal/firmware/stm32f407/PanViewF407/Core/Src/panview_font_16.c

#include "panview_font_16.h"

typedef struct
{
  uint16_t codepoint;
  uint8_t data[32];
} PanViewGlyph16;

/* 字模依据 PCtoLCD2002 说明：阴码、逐行、顺向、高位在前。 */
static const PanViewGlyph16 glyphs[] =
{
  {0x641CU, {0x11U,0x2CU,0x11U,0x24U,0x11U,0x24U,0xFDU,0xACU,0x11U,0x24U,0x11U,0x24U,0x15U,0xFCU,0x18U,0x20U,0x31U,0xFCU,0xD0U,0x88U,0x10U,0x50U,0x10U,0x20U,0x10U,0x50U,0x50U,0x88U,0x23U,0x06U,0x00U,0x00U}},
  {0x7D22U, {0x01U,0x00U,0x3FU,0xF8U,0x01U,0x00U,0x01U,0x00U,0x7FU,0xFEU,0x42U,0x02U,0x84U,0x24U,0x1FU,0xC0U,0x01U,0x80U,0x06U,0x10U,0x3FU,0xF8U,0x01U,0x08U,0x11U,0x20U,0x25U,0x10U,0x42U,0x08U,0x00U,0x00U}},
  {0x8DDFU, {0x7DU,0xF8U,0x45U,0x08U,0x45U,0x08U,0x45U,0xF8U,0x7DU,0x08U,0x11U,0x08U,0x11U,0xF8U,0x5DU,0x44U,0x51U,0x48U,0x51U,0x30U,0x51U,0x20U,0x5DU,0x10U,0xE1U,0x48U,0x01U,0x86U,0x01U,0x00U,0x00U,0x00U}},
  {0x8E2AU, {0x78U,0x20U,0x4BU,0xFEU,0x4AU,0x02U,0x4CU,0x04U,0x79U,0xF8U,0x10U,0x00U,0x10U,0x00U,0x53U,0xFEU,0x5CU,0x20U,0x51U,0x28U,0x51U,0x24U,0x5AU,0x22U,0xE4U,0x22U,0x00U,0xA0U,0x00U,0x40U,0x00U,0x00U}},
  {0x9501U, {0x11U,0x24U,0x3CU,0xA4U,0x20U,0xA8U,0x40U,0x20U,0xBDU,0xFCU,0x11U,0x04U,0x11U,0x24U,0xFDU,0x24U,0x11U,0x24U,0x11U,0x24U,0x11U,0x24U,0x14U,0x50U,0x18U,0x88U,0x11U,0x04U,0x02U,0x02U,0x00U,0x00U}},
  {0x5B9AU, {0x01U,0x00U,0x7FU,0xFEU,0x40U,0x02U,0x80U,0x04U,0x00U,0x00U,0x3FU,0xF8U,0x01U,0x00U,0x01U,0x00U,0x11U,0x00U,0x11U,0xF8U,0x11U,0x00U,0x11U,0x00U,0x29U,0x00U,0x47U,0xFEU,0x80U,0x00U,0x00U,0x00U}},
  {0x4E22U, {0x00U,0xF8U,0x3FU,0x00U,0x01U,0x00U,0x01U,0x00U,0x3FU,0xF8U,0x01U,0x00U,0x01U,0x00U,0x01U,0x00U,0xFFU,0xFEU,0x02U,0x00U,0x04U,0x00U,0x08U,0x20U,0x10U,0x10U,0x3FU,0xF8U,0x10U,0x08U,0x00U,0x00U}},
  {0x5931U, {0x11U,0x00U,0x11U,0x00U,0x11U,0x00U,0x3FU,0xF8U,0x21U,0x00U,0x41U,0x00U,0x01U,0x00U,0xFFU,0xFEU,0x02U,0x80U,0x04U,0x40U,0x04U,0x40U,0x08U,0x20U,0x10U,0x10U,0x20U,0x08U,0xC0U,0x06U,0x00U,0x00U}},
  {0x6545U, {0x10U,0x40U,0x10U,0x40U,0x10U,0x80U,0xFEU,0xFEU,0x11U,0x08U,0x12U,0x88U,0x10U,0x88U,0x7CU,0x88U,0x44U,0x50U,0x44U,0x50U,0x44U,0x20U,0x44U,0x50U,0x7CU,0x88U,0x45U,0x04U,0x02U,0x02U,0x00U,0x00U}},
  {0x969CU, {0x7DU,0xFCU,0x44U,0x88U,0x48U,0x50U,0x4BU,0xFEU,0x50U,0x00U,0x49U,0xFCU,0x49U,0x04U,0x45U,0xFCU,0x45U,0x04U,0x45U,0xFCU,0x68U,0x20U,0x53U,0xFEU,0x40U,0x20U,0x40U,0x20U,0x40U,0x20U,0x00U,0x00U}},
  {0x76EEU, {0x3FU,0xF8U,0x20U,0x08U,0x20U,0x08U,0x20U,0x08U,0x3FU,0xF8U,0x20U,0x08U,0x20U,0x08U,0x20U,0x08U,0x3FU,0xF8U,0x20U,0x08U,0x20U,0x08U,0x20U,0x08U,0x20U,0x08U,0x3FU,0xF8U,0x20U,0x08U,0x00U,0x00U}},
  {0x6807U, {0x11U,0xFCU,0x10U,0x00U,0x10U,0x00U,0xFCU,0x00U,0x13U,0xFEU,0x30U,0x20U,0x38U,0x20U,0x55U,0x28U,0x55U,0x24U,0x92U,0x24U,0x12U,0x22U,0x14U,0x22U,0x10U,0x20U,0x10U,0xA0U,0x10U,0x40U,0x00U,0x00U}}
  ,{0x8BBEU, {0x21U,0xF0U,0x11U,0x10U,0x11U,0x10U,0x01U,0x10U,0x02U,0x0EU,0xF4U,0x00U,0x13U,0xF8U,0x11U,0x08U,0x11U,0x10U,0x10U,0x90U,0x14U,0xA0U,0x18U,0x40U,0x10U,0xA0U,0x03U,0x18U,0x0CU,0x06U,0x00U,0x00U}}
  ,{0x8BCAU, {0x40U,0x40U,0x20U,0xA0U,0x21U,0x10U,0x02U,0x08U,0x04U,0x26U,0xE0U,0x40U,0x20U,0x80U,0x23U,0x10U,0x20U,0x20U,0x20U,0x40U,0x28U,0x88U,0x33U,0x10U,0x20U,0x20U,0x00U,0xC0U,0x07U,0x00U,0x00U,0x00U}}
  ,{0x65ADU, {0x04U,0x04U,0x55U,0x78U,0x4EU,0x40U,0x44U,0x40U,0x7FU,0x40U,0x44U,0x7EU,0x4EU,0x48U,0x55U,0x48U,0x65U,0x48U,0x44U,0x48U,0x44U,0x48U,0x40U,0x48U,0x7FU,0x88U,0x00U,0x88U,0x01U,0x08U,0x00U,0x00U}}
  ,{0x8FD4U, {0x20U,0x3CU,0x13U,0xC0U,0x12U,0x00U,0x02U,0x00U,0x03U,0xFCU,0xF2U,0x04U,0x12U,0x88U,0x12U,0x50U,0x12U,0x20U,0x12U,0x50U,0x14U,0x88U,0x15U,0x04U,0x28U,0x00U,0x47U,0xFEU,0x00U,0x00U,0x00U,0x00U}}
  ,{0x56DEU, {0x3FU,0xF8U,0x20U,0x08U,0x20U,0x08U,0x27U,0xC8U,0x24U,0x48U,0x24U,0x48U,0x24U,0x48U,0x24U,0x48U,0x24U,0x48U,0x27U,0xC8U,0x20U,0x08U,0x20U,0x08U,0x3FU,0xF8U,0x20U,0x08U,0x00U,0x00U,0x00U,0x00U}}
  ,{0x4E2DU, {0x01U,0x00U,0x01U,0x00U,0x01U,0x00U,0x3FU,0xF8U,0x21U,0x08U,0x21U,0x08U,0x21U,0x08U,0x21U,0x08U,0x21U,0x08U,0x3FU,0xF8U,0x21U,0x08U,0x01U,0x00U,0x01U,0x00U,0x01U,0x00U,0x00U,0x00U,0x00U,0x00U}}
  ,{0x6587U, {0x01U,0x00U,0x01U,0x00U,0xFFU,0xFEU,0x10U,0x10U,0x10U,0x10U,0x08U,0x20U,0x08U,0x20U,0x04U,0x40U,0x02U,0x80U,0x01U,0x00U,0x02U,0x80U,0x04U,0x40U,0x08U,0x20U,0x30U,0x18U,0xC0U,0x06U,0x00U,0x00U}}
};

const uint8_t *PanViewFont16_Find(uint16_t codepoint)
{
  uint32_t index;
  for (index = 0U; index < (sizeof(glyphs) / sizeof(glyphs[0])); index++)
  {
    if (glyphs[index].codepoint == codepoint)
    {
      return glyphs[index].data;
    }
  }
  return (const uint8_t *)0;
}
