jiang-zexuan/k230-42-stepper-vision-tracking-2d-gimbal/(commit log)

2026-08-13 docs: 建立 PanView 项目基线
2026-08-13 chore: 初始化远端仓库
2026-08-13 chore: 清理远端初始化文件
2026-08-14 docs: 增加项目化学习规划书
2026-08-14 docs: 补充 GitHub 协作规则
2026-08-14 docs: 补充 P01 板级诊断台设计
2026-08-14 docs: 增加 P01 板级诊断需求追踪
2026-08-14 test: 增加 P01 诊断状态单元测试
2026-08-15 feat: 建立 P01 F407 板级诊断工程
2026-08-15 docs: 记录 P01 板级诊断学习复盘
2026-08-15 test: 记录 P01 F407 板级诊断实测
2026-08-15 feat: 实现 P02 非阻塞周期任务
2026-08-15 test: 记录 P02 非阻塞任务实测
2026-08-15 docs: 补充 P02 状态机学习问答
2026-08-15 docs: 增加中文学习导航和代码注释
2026-08-15 feat: 实现 P03 UART DMA 协议实验器
2026-08-15 docs: 记录 P03 实测并统一学习笔记口吻
2026-08-16 feat: 增加P04 K230视觉结果UART文本发布
2026-08-16 docs(p04): 记录 K230 视觉结果实测
2026-08-21 feat: 完成P05单轴闭环电机验收
2026-08-21 docs: 更新GitHub项目地址
2026-08-21 feat: 建立P06水平轴软件限位
2026-08-22 feat: 完成P06单轴运动控制器实测
2026-08-22 feat: 完成 P07 双轴云台基础控制器
2026-08-22 feat: 完成P08视觉通信链路验证与复盘
2026-08-22 docs: 补充P08逻辑分析仪复测证据
2026-08-23 feat: 完成P09水平视觉跟踪阶段性实测
2026-08-23 feat: 完成P10触摸交互验证与复盘
2026-08-23 feat: 增加P10视觉状态机与状态仪表盘
2026-08-23 fix: 避免仪表盘刷新阻塞视觉运动
2026-08-23 perf: 优化P10仪表盘局部刷新
2026-08-23 feat: 接入ES8388状态语音播报
2026-08-24 feat(p10): add hit audio and stabilize visual tracking
    [audio_player.c, audio_player.h, hit.c, main.c, visual_track_controller.c, visual_track_controller.h, visual_track_controller_test.c]
2026-08-24 feat(p11): 完成 FreeRTOS 故障管理与看门狗收尾
    完成任务拆分、遥测、触摸队列、安全停机和 IWDG 接入；记录任务堆不足导致复位循环的定位与修复，并保留 Keil 工程收尾配置。
    [PanViewF407.ioc, main.c, main.h, usart.c]
2026-08-24 docs: 同步 P11 收尾状态与 P12 入口
2026-08-25 docs(p11): 补充看门狗复位排查复盘
2026-08-26 feat(p12): 接入自定义模型并完善TFT控制台
2026-08-26 docs: 更新公开项目文档
2026-08-26 docs: 精简公开项目文档
2026-08-27 feat(p12): 整理视觉云台成品展示与可移植工程
2026-08-27 fix: 修复 README 实物图片展示路径
2026-08-27 fix: 恢复 README 实物图片二进制内容
2026-08-27 fix: 调整 README 图片兼容链接
2026-08-27 docs: 更新最终硬件方案与成品展示
2026-08-27 docs: 修正演示视频直链
2026-08-27 docs: 更新演示视频下载说明
2026-09-02 docs: 建立FreeRTOS重构任务规划与引脚基线
2026-09-02 docs: 修正重构工程路径与接线基线
2026-09-03 feat: replace UART slot queue with byte ring buffer
    [panview_ring_buffer.c, panview_ring_buffer.h, panview_uart_rx.c, panview_uart_rx.h, usart.c]
2026-09-04 feat: 完成T07双轴步进电机执行与实机调试
2026-09-04 feat: 完成T08安全任务与故障注入测试
