jiang-zexuan/k230-42-stepper-vision-tracking-2d-gimbal/(notices)

Notices in the files:
firmware/stm32f407/PanViewFreeRTOS/Core/Src/usart.c:
Copyright (c) 2026 STMicroelectronics.
All rights reserved.
This software is licensed under terms that can be found in the LICENSE file
